Blevo66/chassis-bench/files/rocker-c/rocker-h-smooth-3d-under.gif

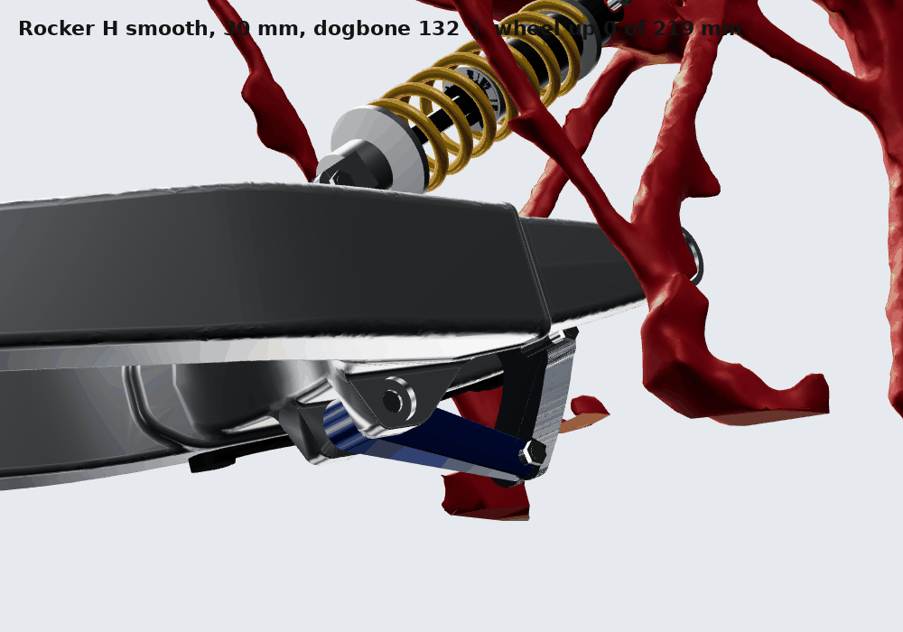
files/rocker-c/rocker-h-smooth-3d-under.gif
