Blevo66/chassis-bench/files/rocker-c/render-joel-rocker/render-side.jpg

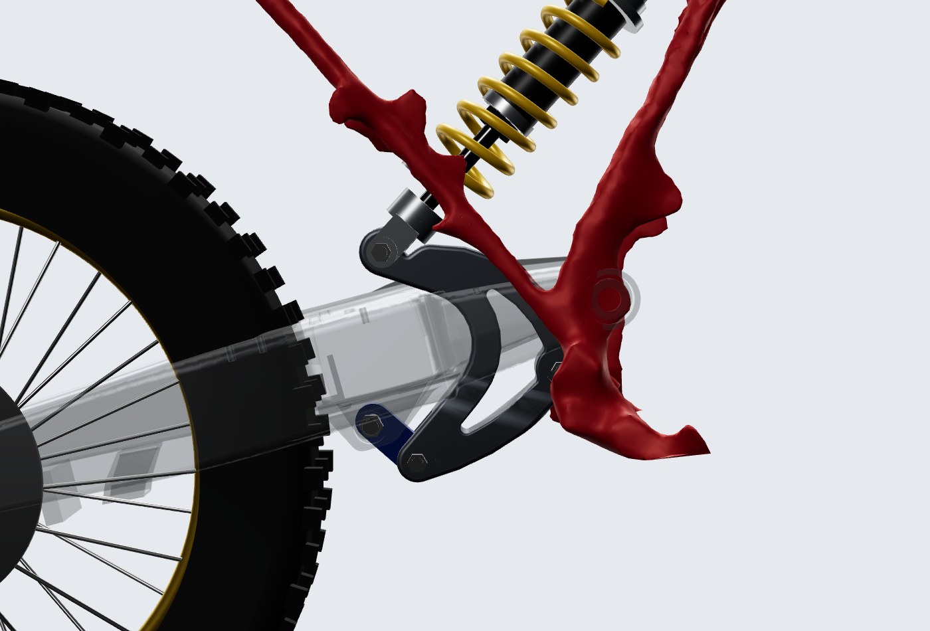
files/rocker-c/render-joel-rocker/render-side.jpg
