Blevo66/chassis-bench/files/sketches/bike-sketch-sheets-concept-50.pdf

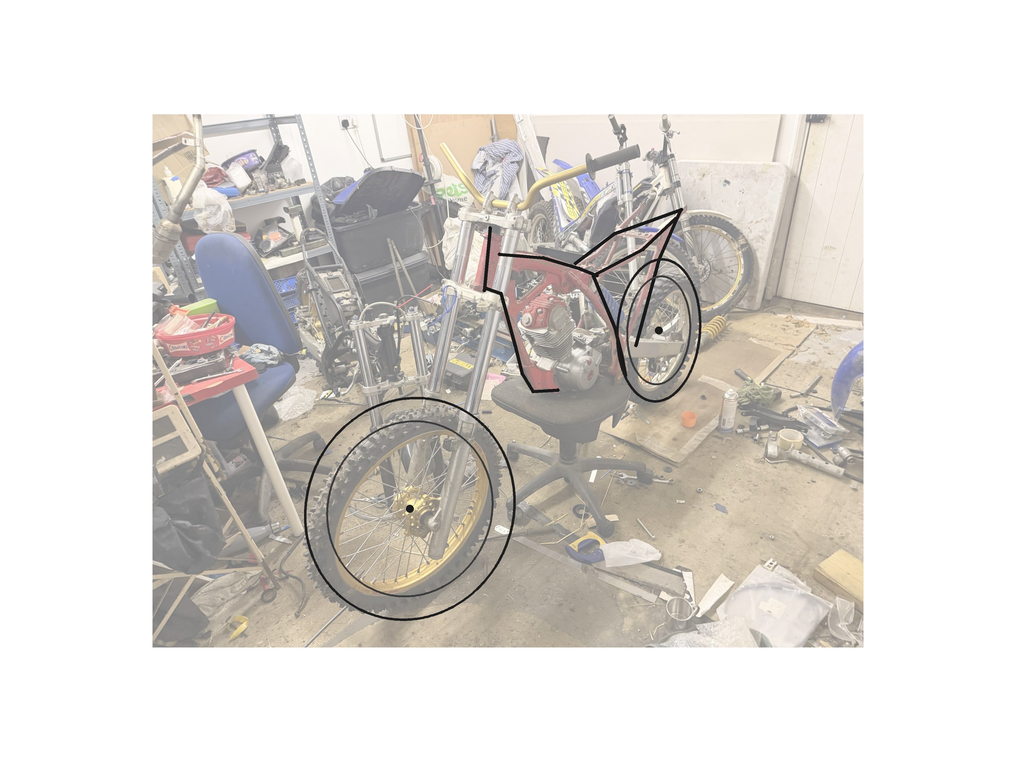
[picture p3: page 1]
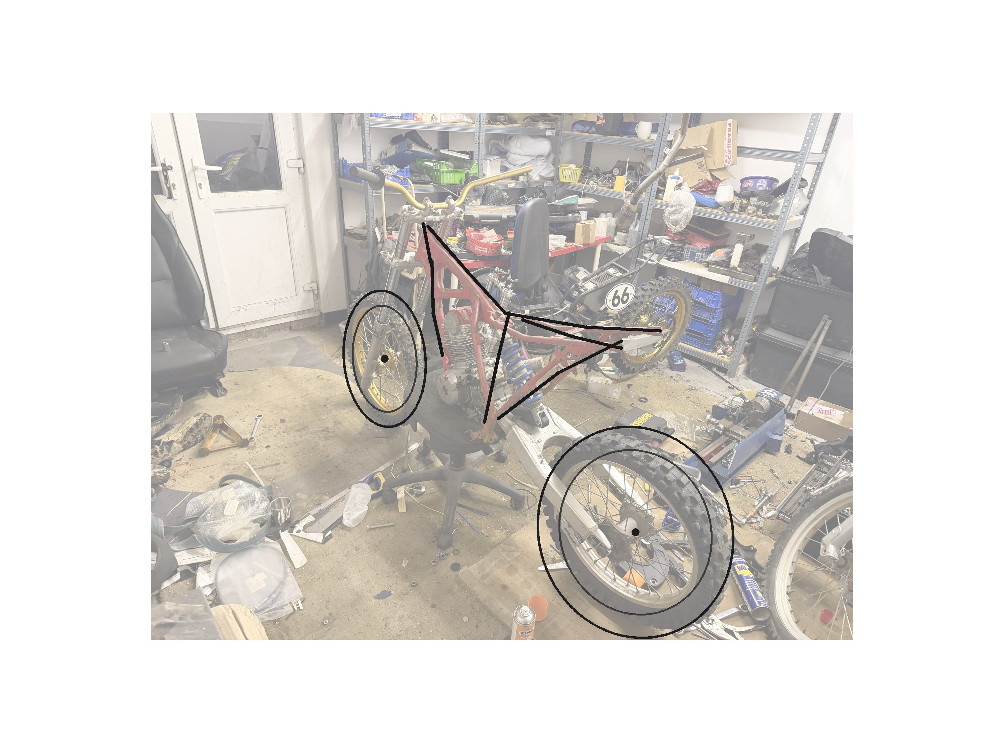
[picture p4: page 2]
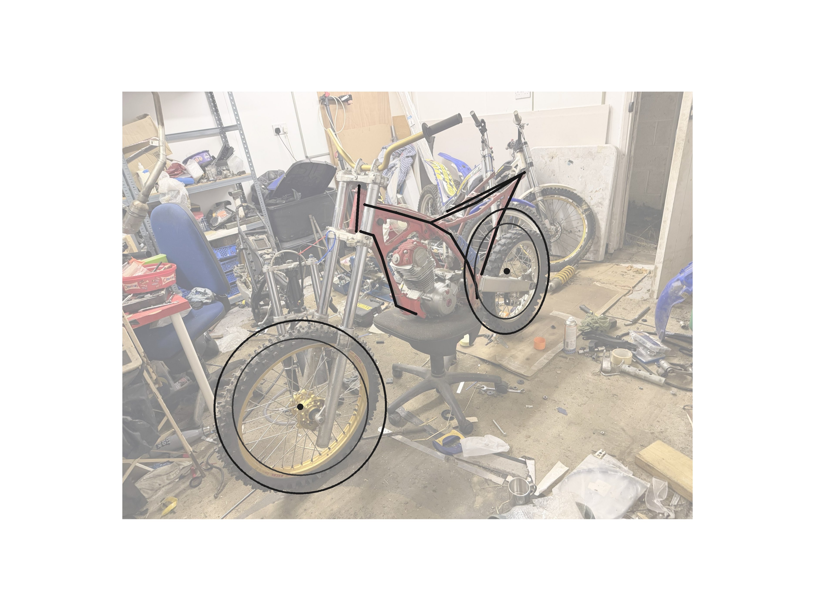
[picture p5: page 3]
