Blevo66/chassis-bench/files/sketches/bike-sketch-sheets-concept.pdf

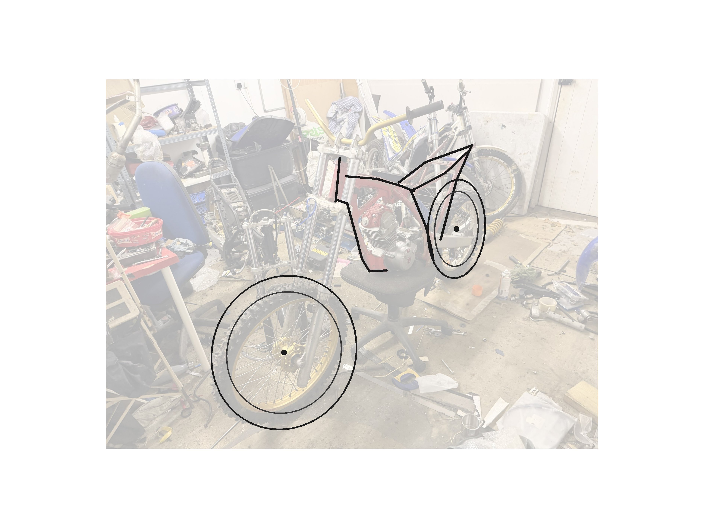
[picture p6: page 1]
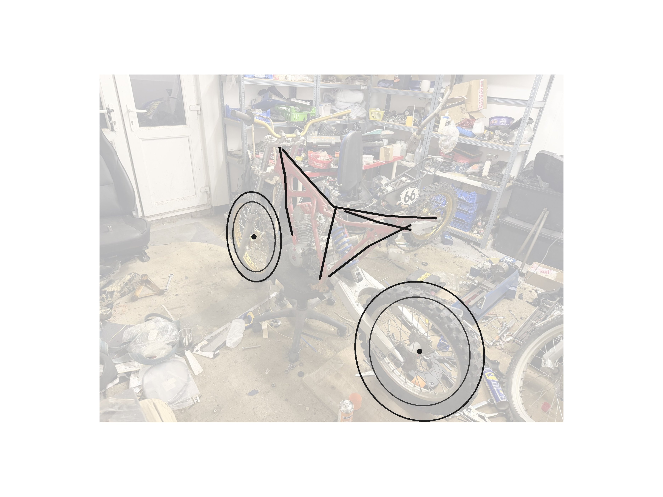
[picture p7: page 2]
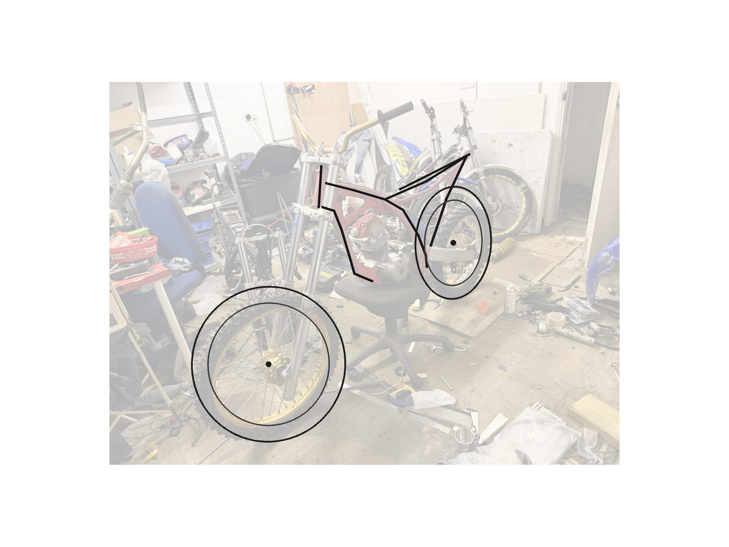
[picture p8: page 3]
