Blevo66/chassis-bench/files/sketches/bike-sketch-sheets-landscape-50.pdf

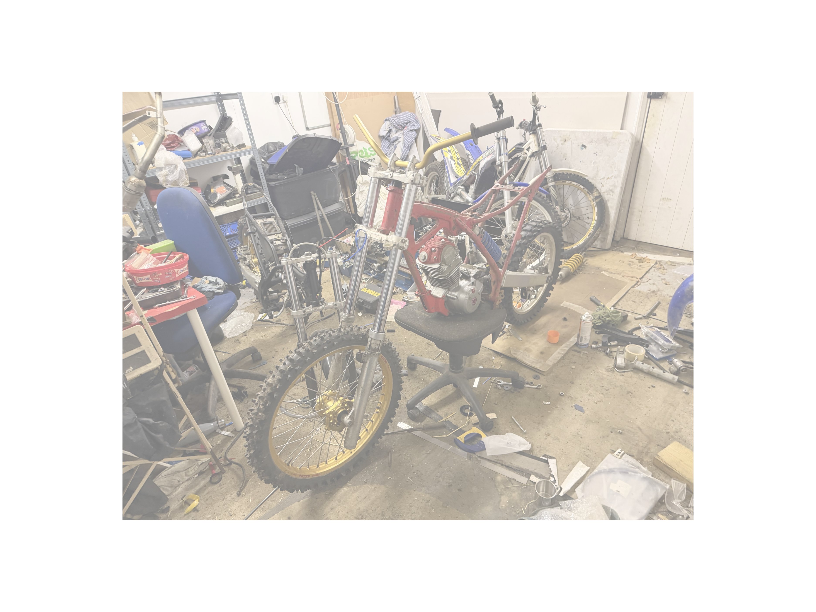
[picture p9: page 1]
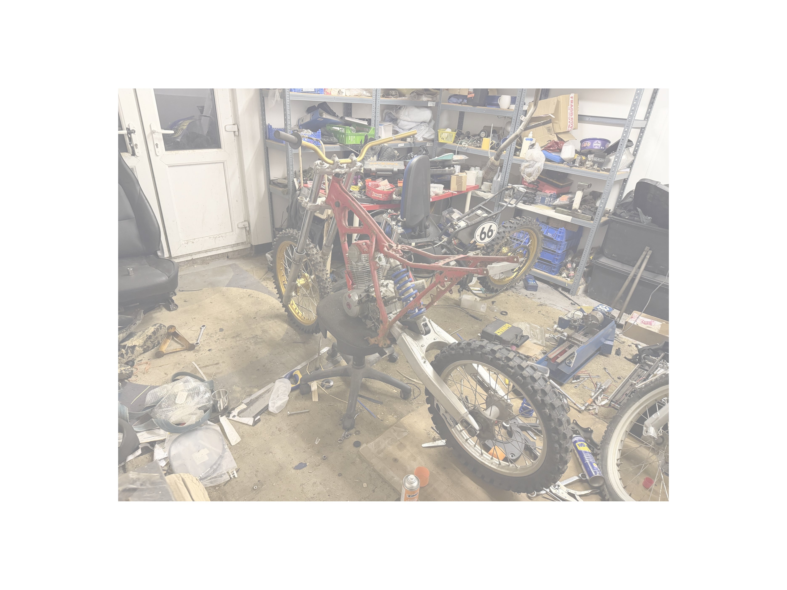
[picture p10: page 2]
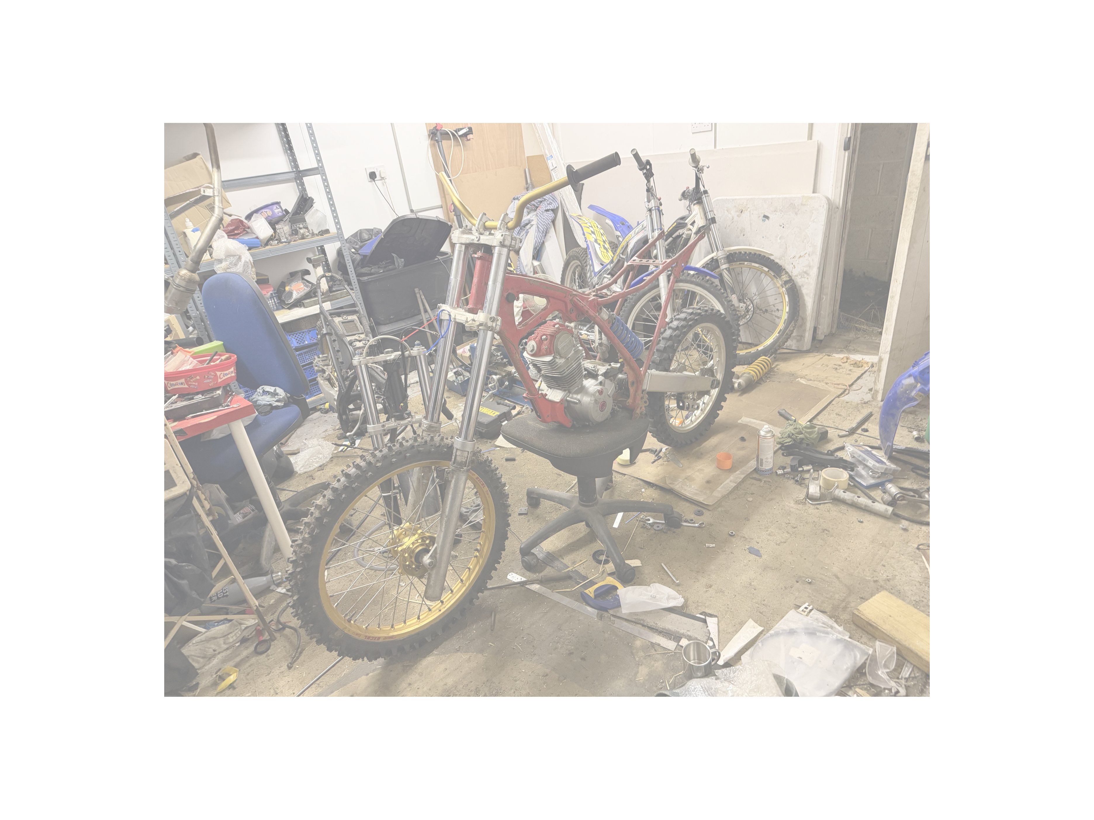
[picture p11: page 3]
