Blevo66/chassis-bench/files/sketches/bike-sketch-sheets.pdf

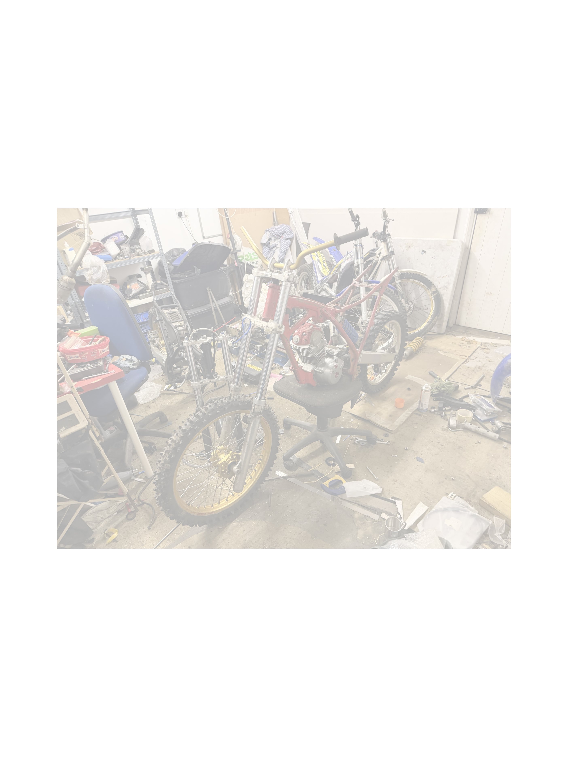
[picture p15: page 1]
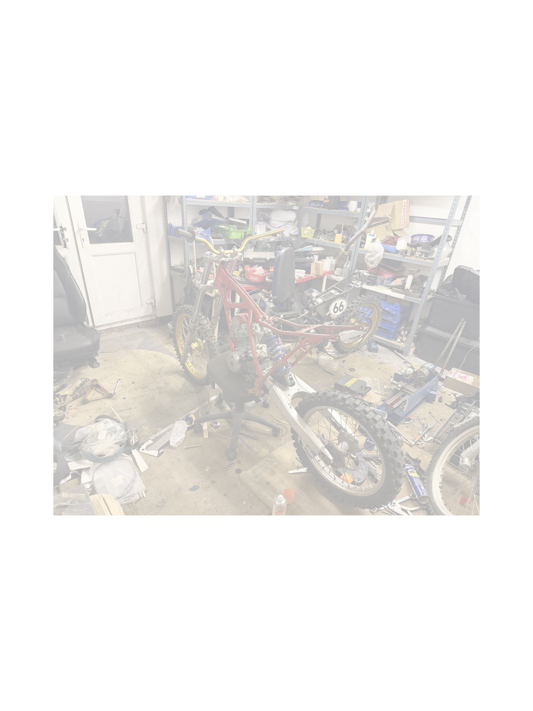
[picture p16: page 2]
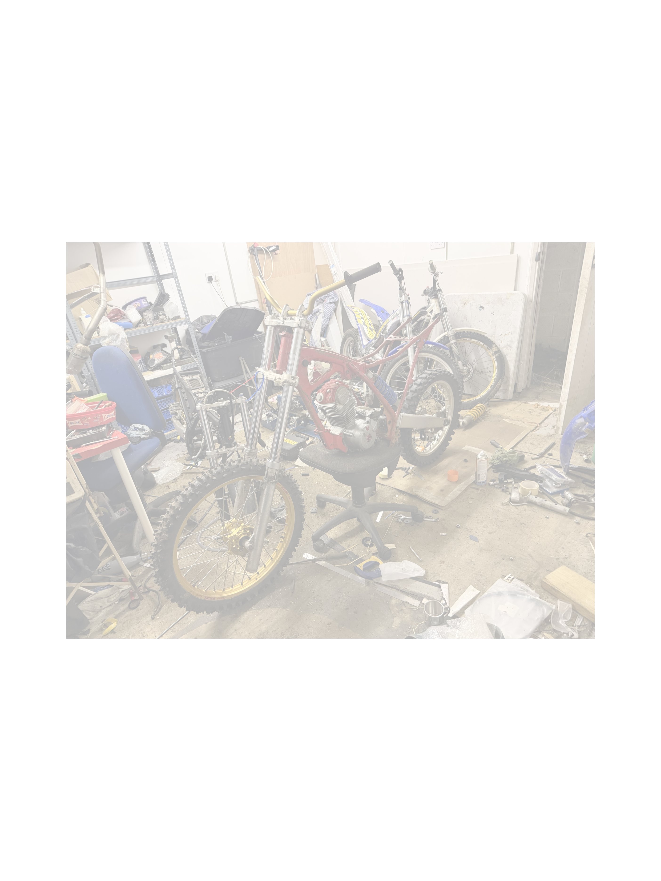
[picture p17: page 3]
