Blevo66/chassis-bench/files/linkage/compare-A-B.png

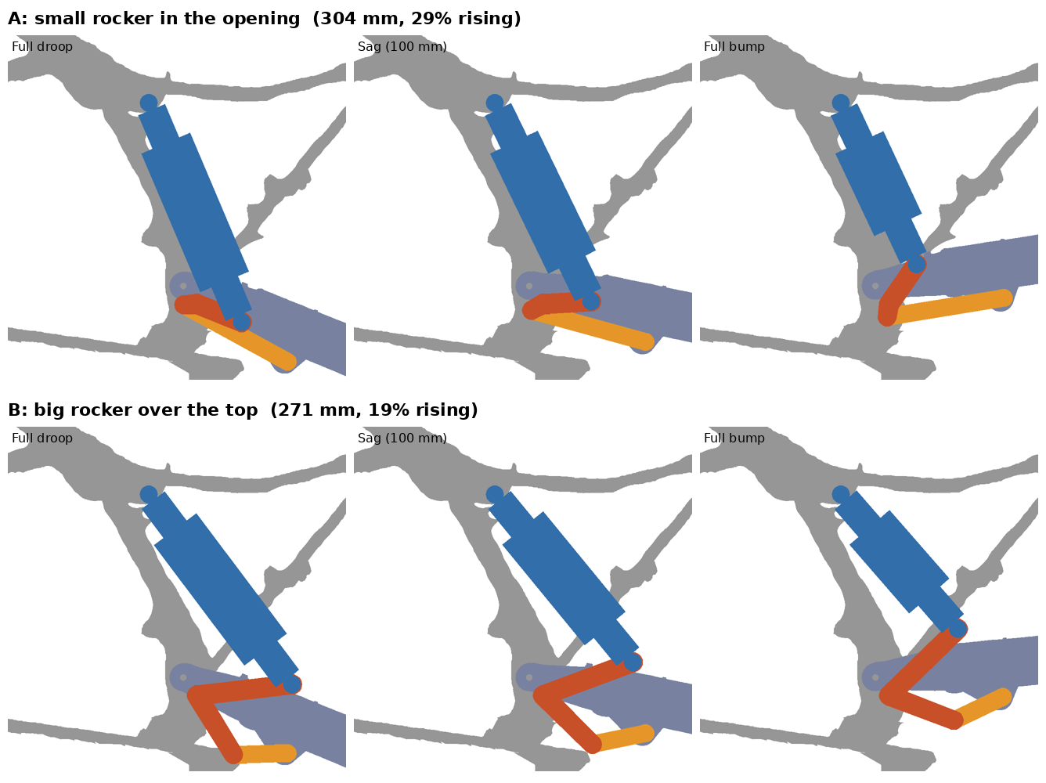
files/linkage/compare-A-B.png
