Blevo66/chassis-bench/files/rocker-c/crf-style-check.png

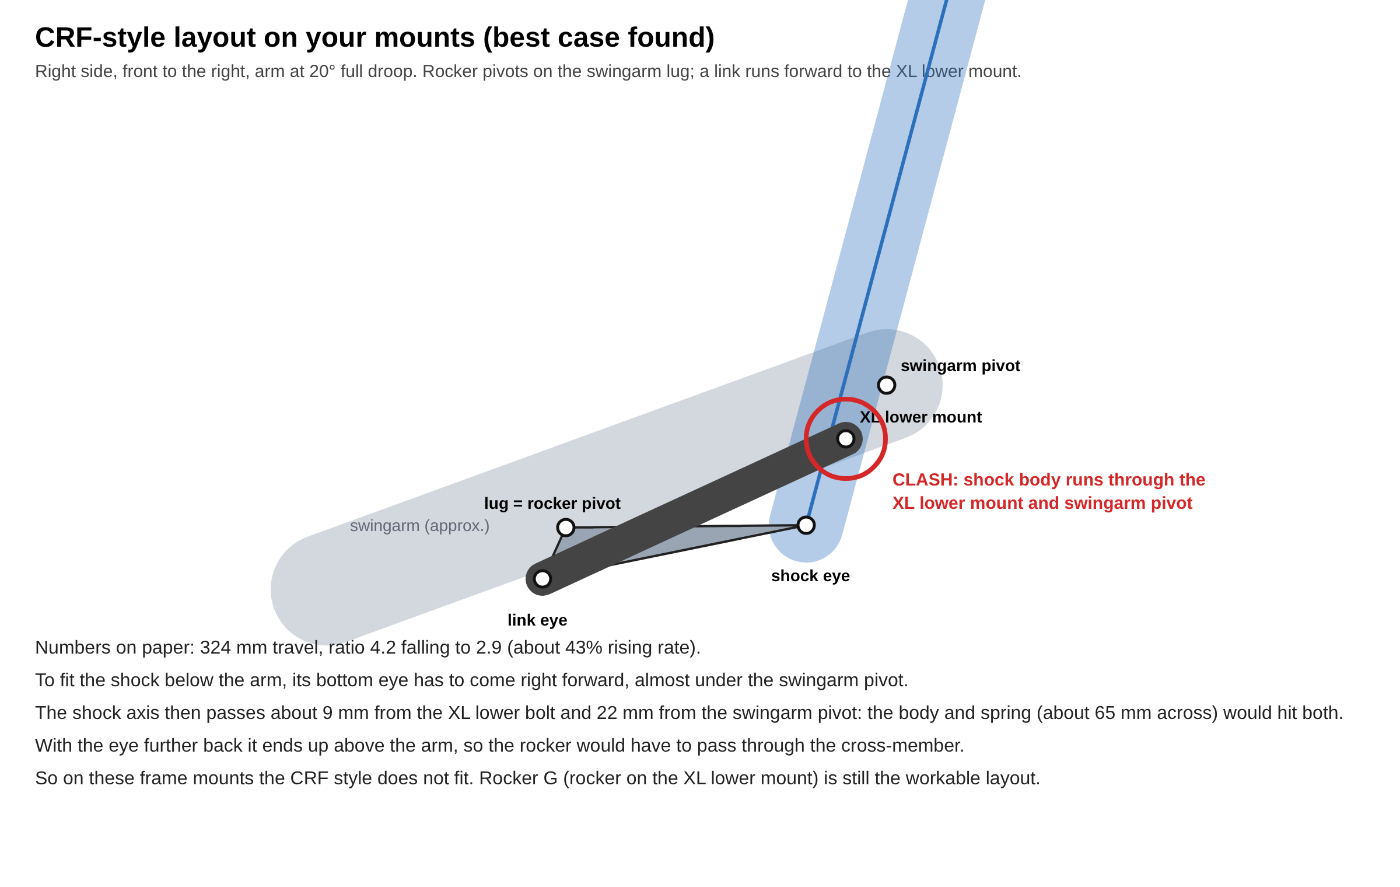
files/rocker-c/crf-style-check.png
