Blevo66/chassis-bench/files/rocker-c/gap-options.png

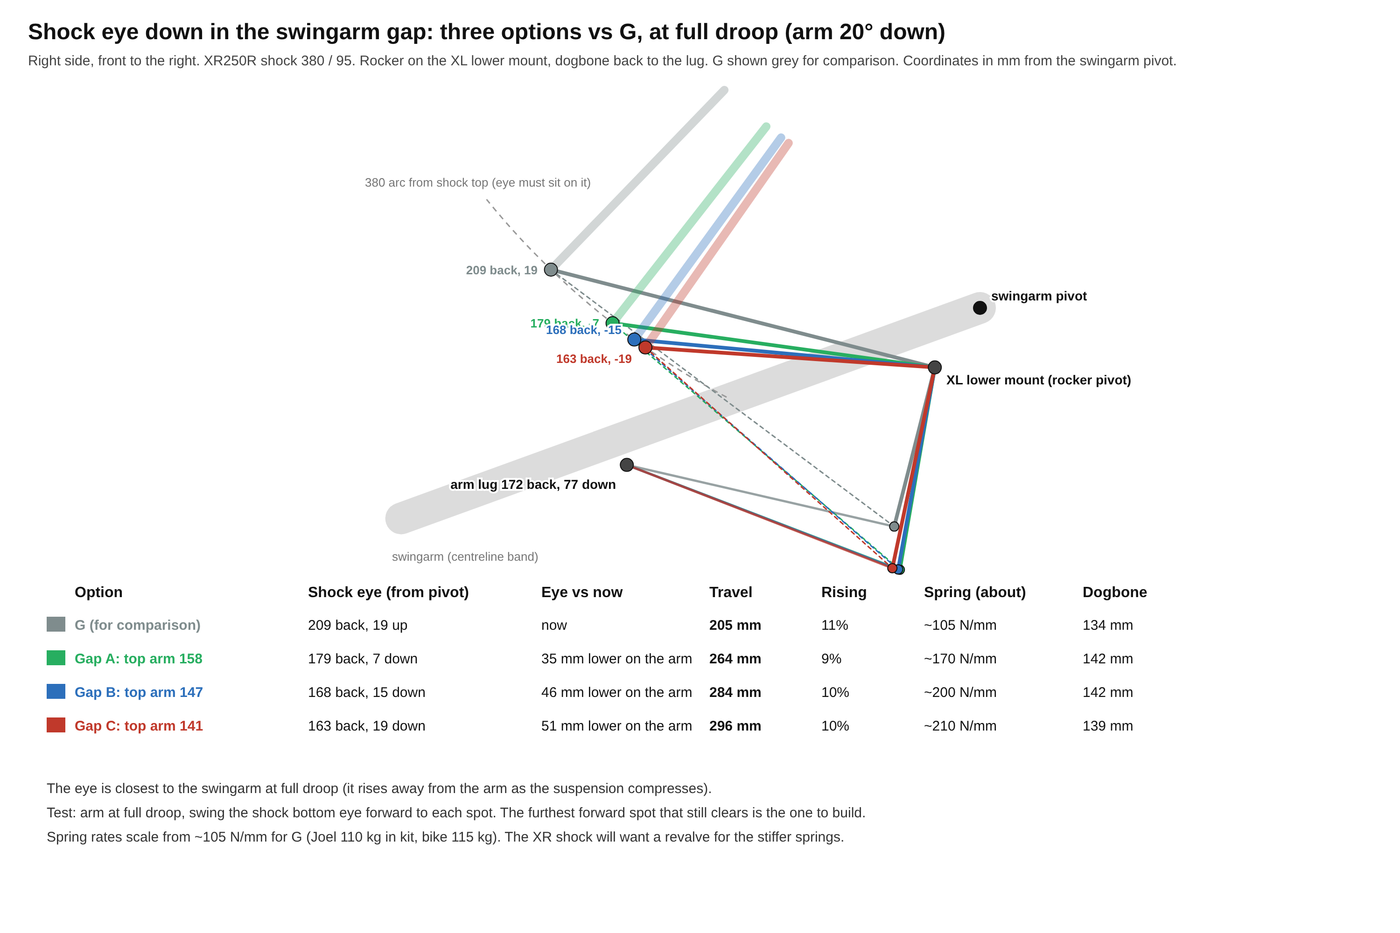
files/rocker-c/gap-options.png
