Blevo66/chassis-bench/files/rocker-c/render-joel-rocker/render-bottom.jpg

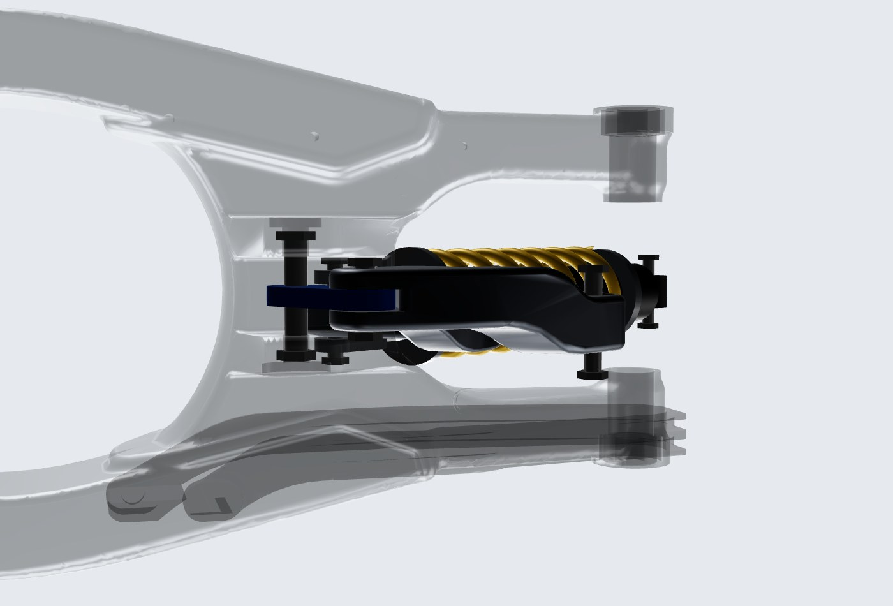
files/rocker-c/render-joel-rocker/render-bottom.jpg
