Blevo66/chassis-bench/files/rocker-c/render-joel-rocker/render-front34.jpg

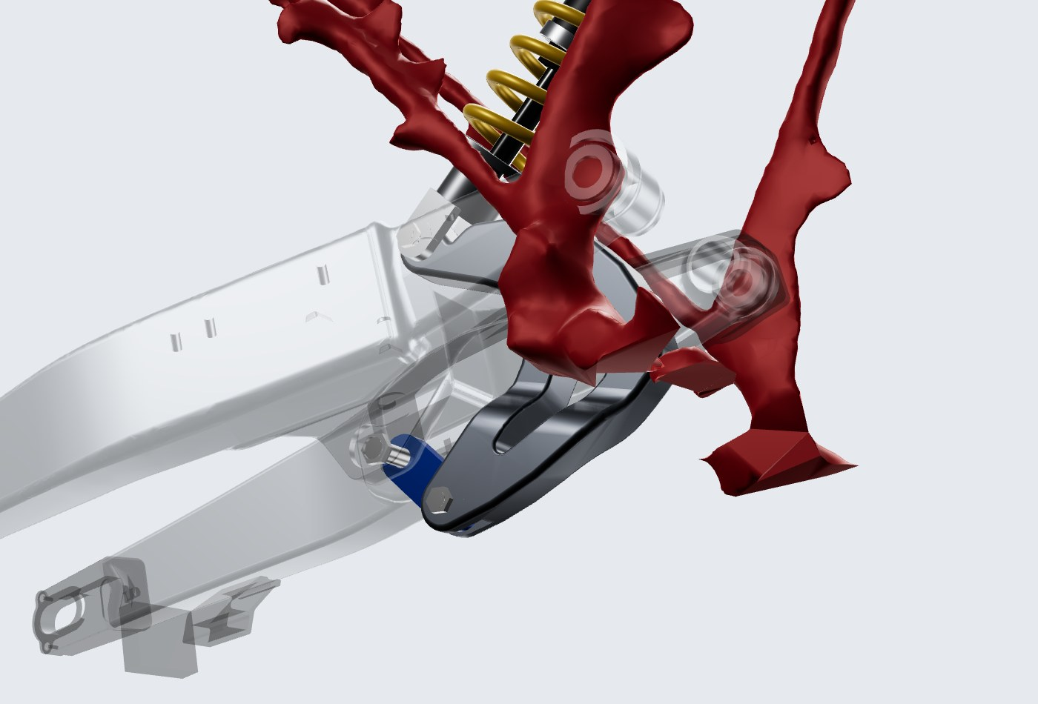
files/rocker-c/render-joel-rocker/render-front34.jpg
