Blevo66/chassis-bench/files/rocker-c/render-joel-rocker/render-hero.jpg

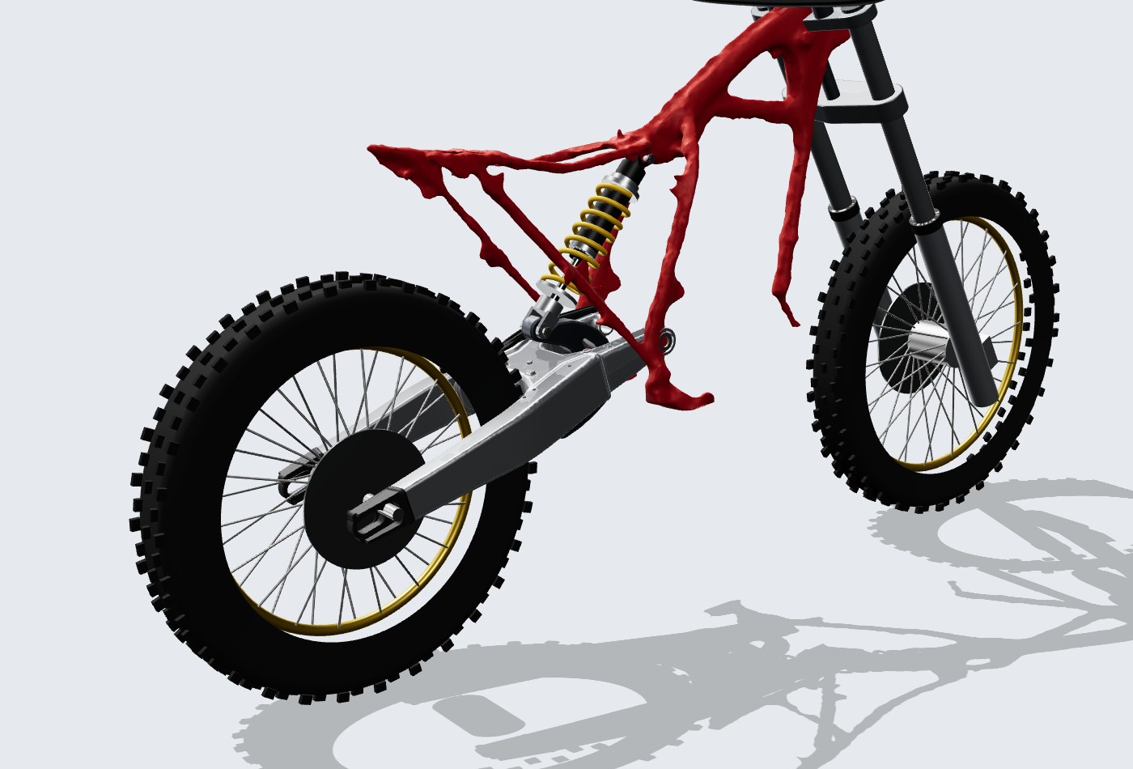
files/rocker-c/render-joel-rocker/render-hero.jpg
