Blevo66/chassis-bench/files/rocker-c/render-joel-rocker/render-side_bump.jpg

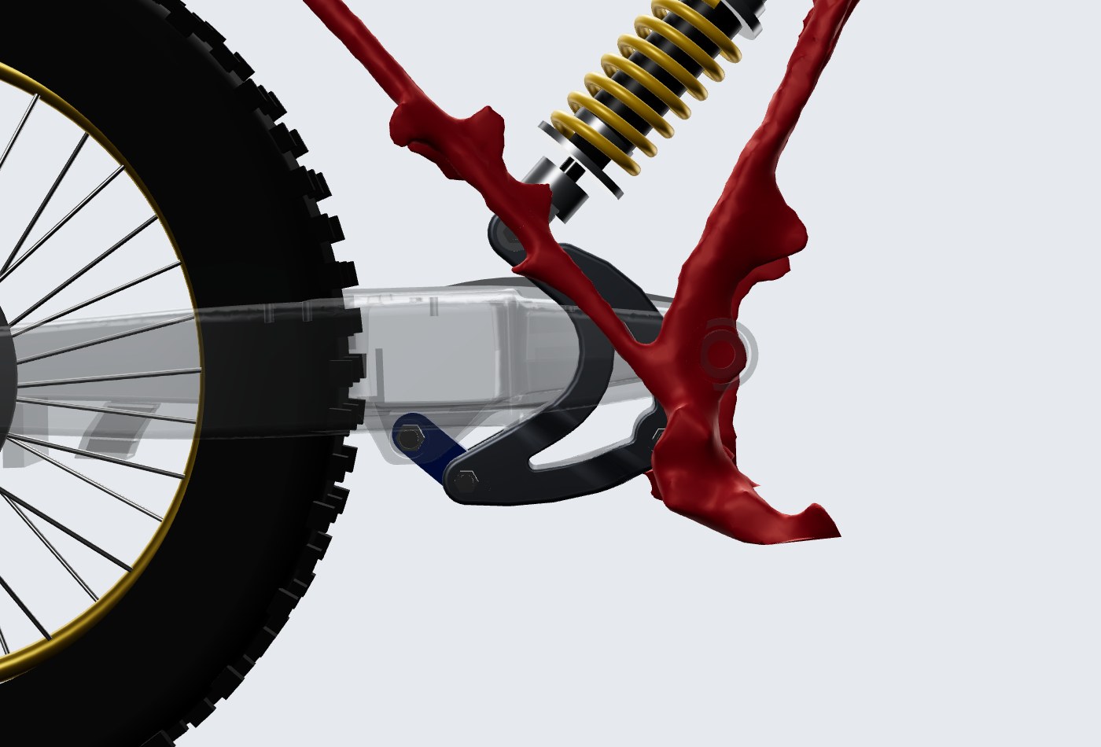
files/rocker-c/render-joel-rocker/render-side_bump.jpg
