Blevo66/chassis-bench/files/rocker-c/render-joel-rocker/render-side_droop.jpg

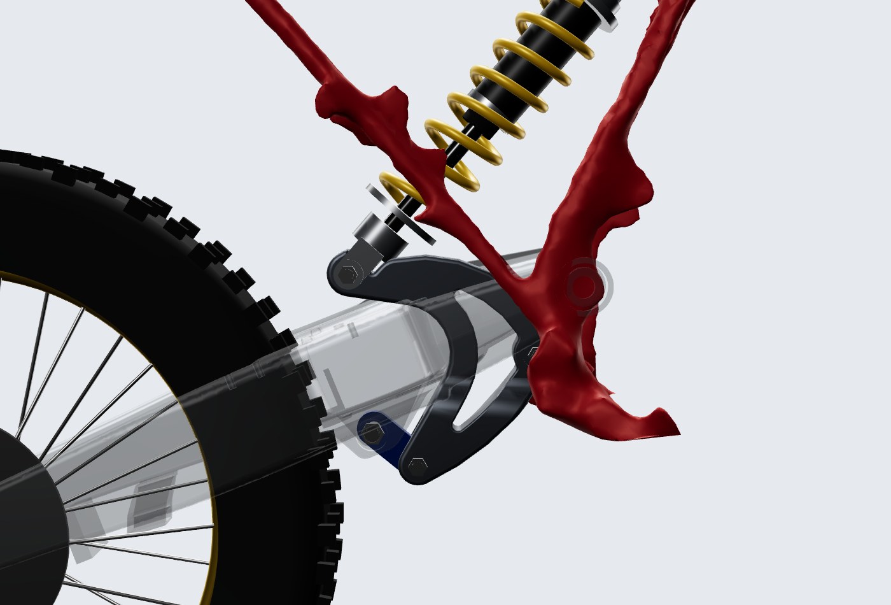
files/rocker-c/render-joel-rocker/render-side_droop.jpg
