Blevo66/chassis-bench/files/rocker-c/render-joel-rocker/render-under.jpg

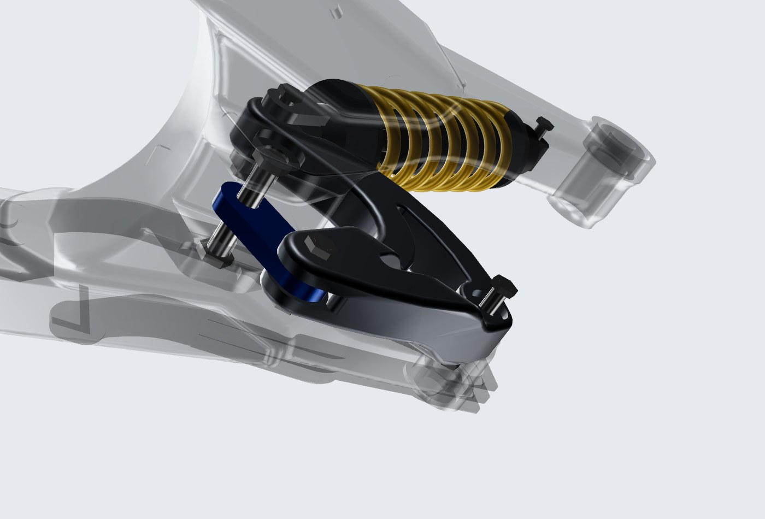
files/rocker-c/render-joel-rocker/render-under.jpg
