Blevo66/chassis-bench/files/rocker-c/render-joel-rocker/rocker-travel-front34.gif

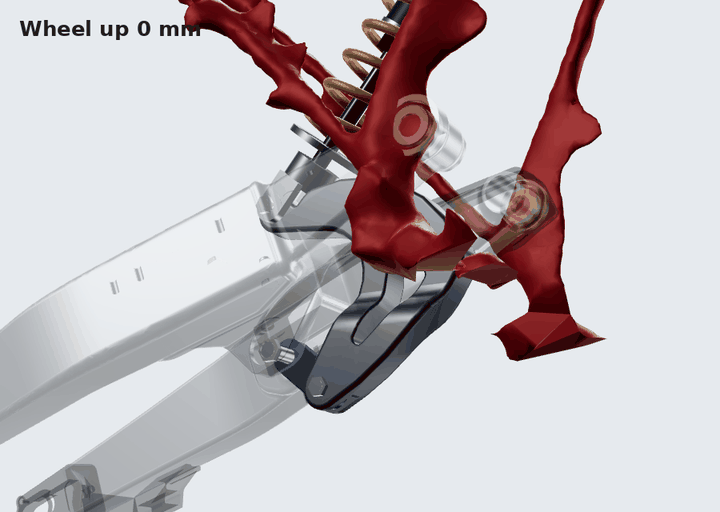
files/rocker-c/render-joel-rocker/rocker-travel-front34.gif
