Blevo66/chassis-bench/files/rocker-c/render-rocker-v3/alone_a.jpg

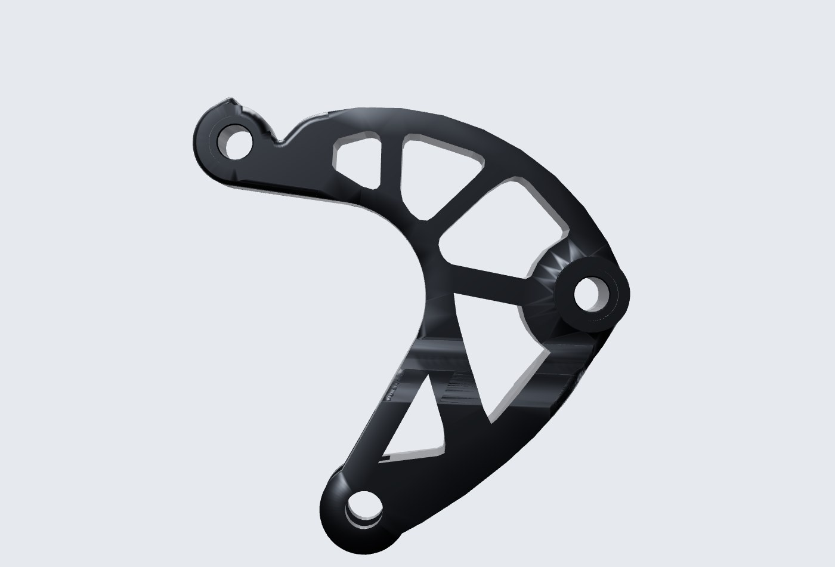
files/rocker-c/render-rocker-v3/alone_a.jpg
