Blevo66/chassis-bench/files/rocker-c/render-rocker-v3/alone_b.jpg

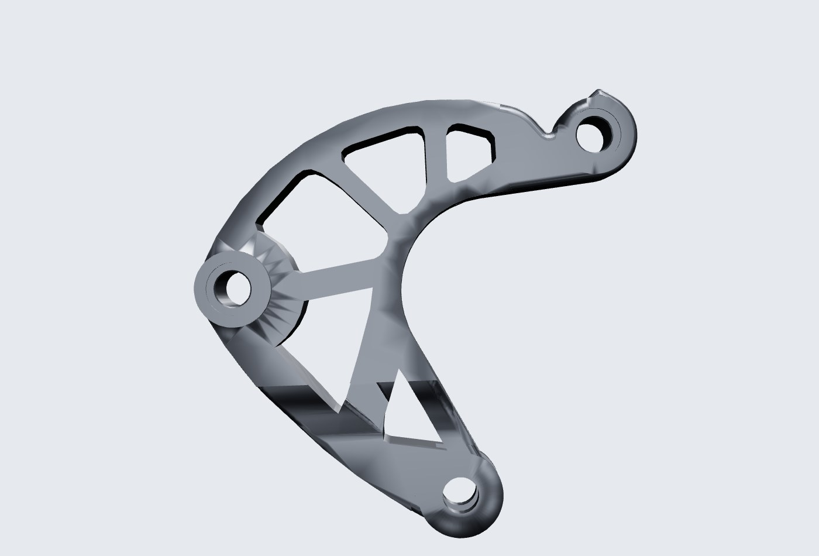
files/rocker-c/render-rocker-v3/alone_b.jpg
