Blevo66/chassis-bench/files/rocker-c/render-rocker-v3/pivot_close.jpg

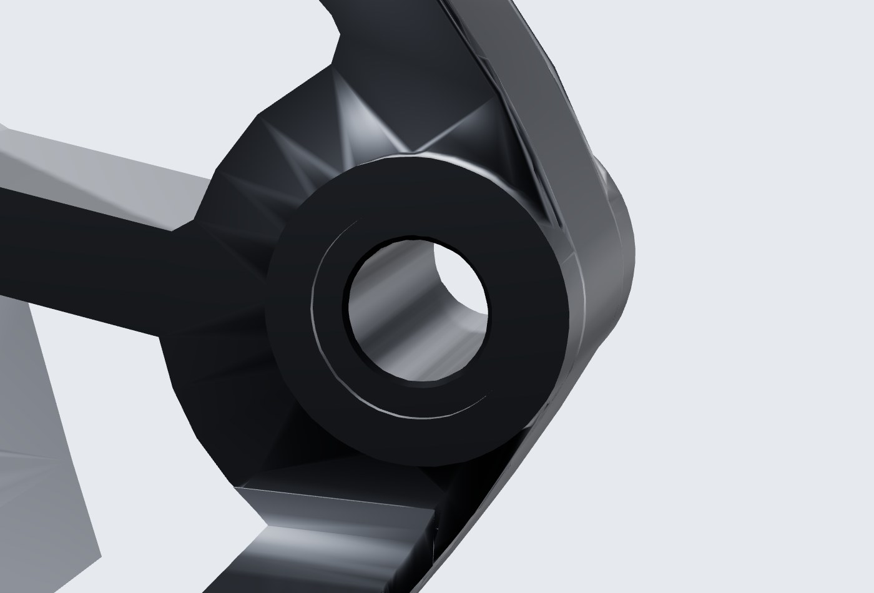
files/rocker-c/render-rocker-v3/pivot_close.jpg
