Blevo66/chassis-bench/files/rocker-c/render-rocker-v3/pivot_close_b.jpg

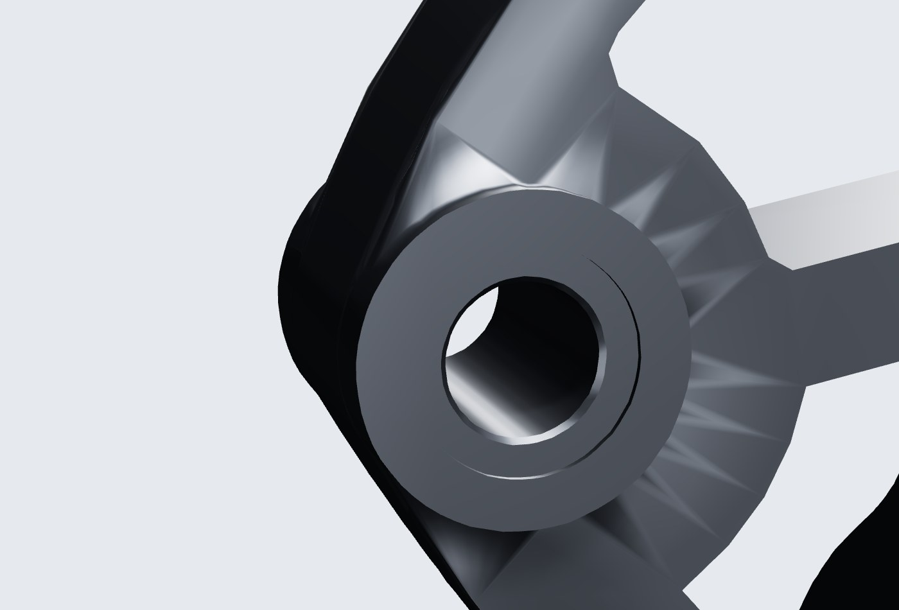
files/rocker-c/render-rocker-v3/pivot_close_b.jpg
