Blevo66/chassis-bench/files/rocker-c/render-rocker-v3/shock_close.jpg

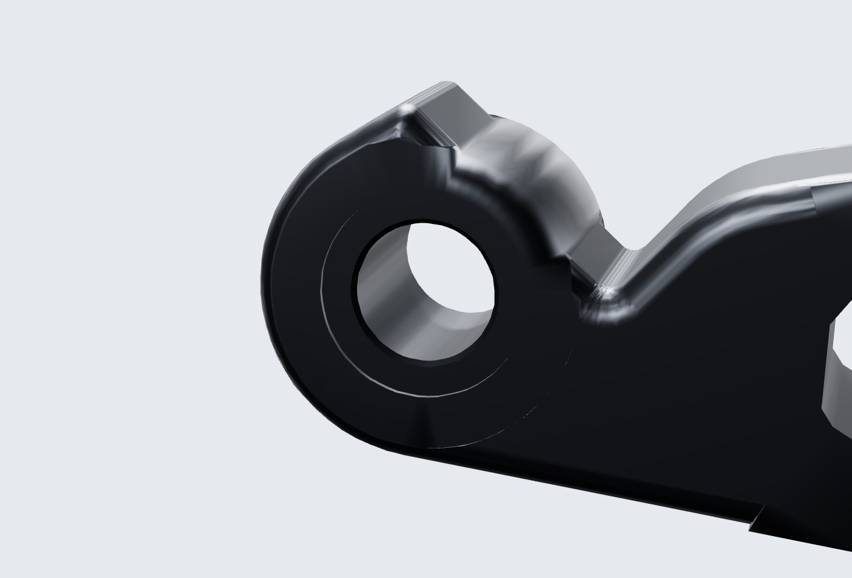
files/rocker-c/render-rocker-v3/shock_close.jpg
