Blevo66/chassis-bench/files/rocker-c/rocker-c-205-drawing.png

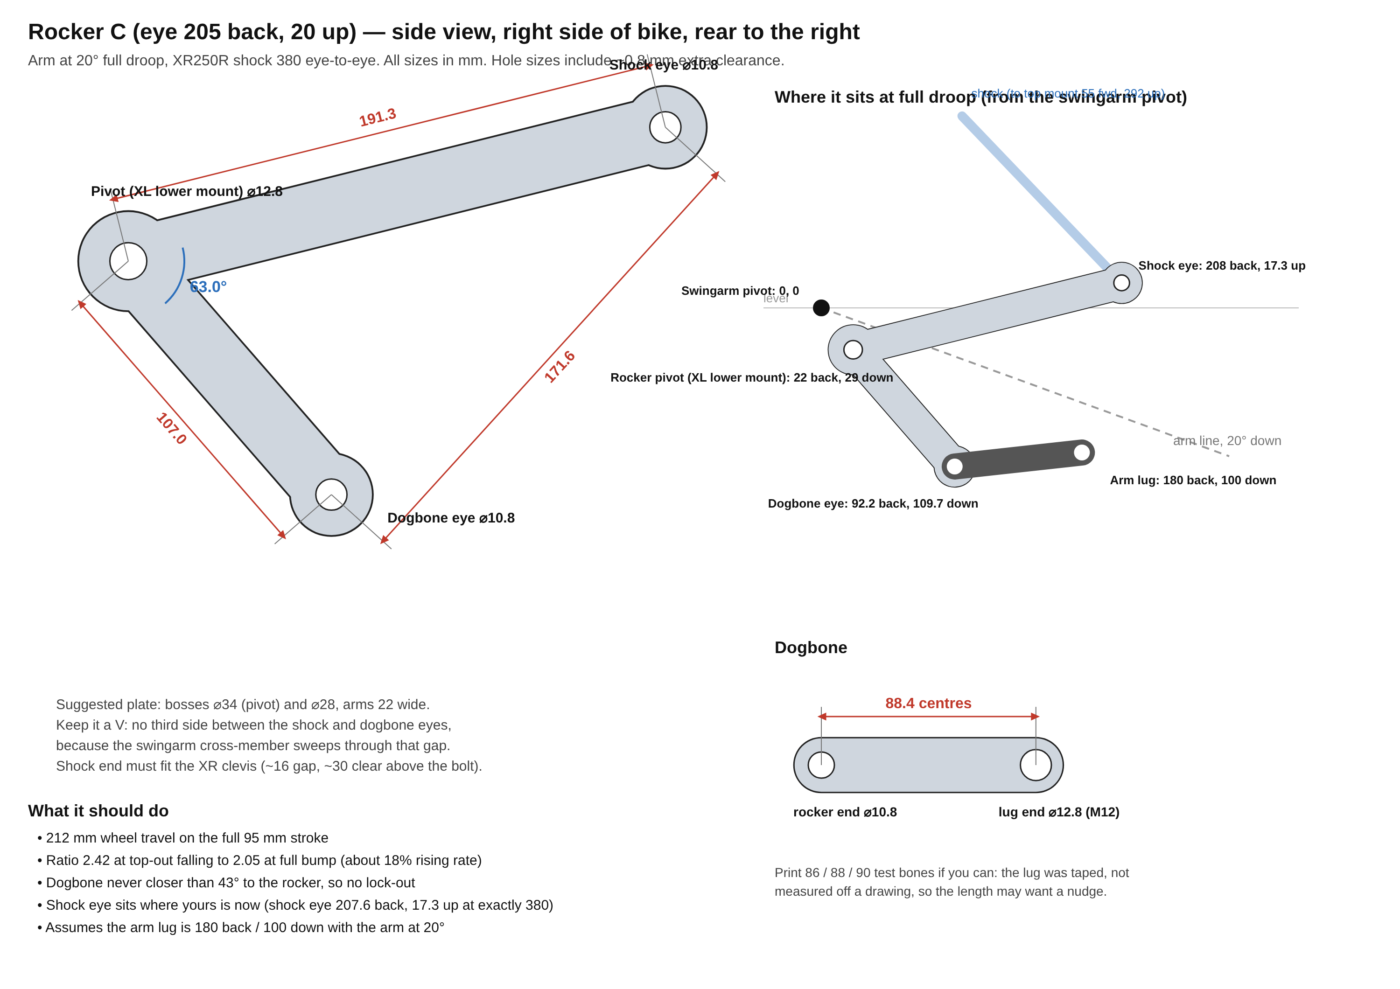
files/rocker-c/rocker-c-205-drawing.png
