Blevo66/chassis-bench/files/rocker-c/rocker-d2-drawing.png

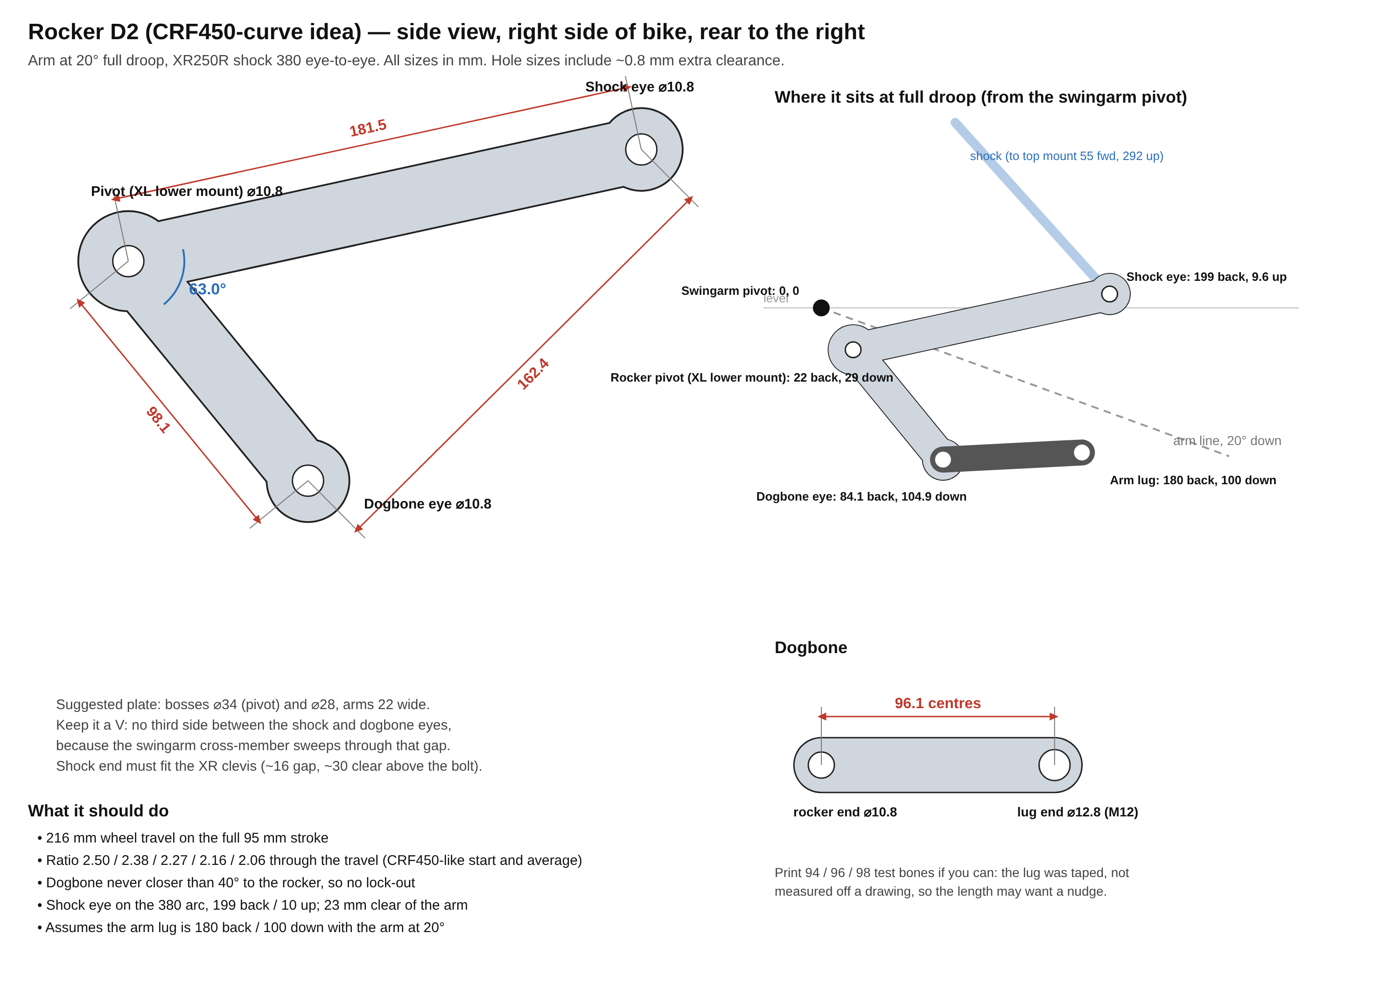
files/rocker-c/rocker-d2-drawing.png
