Blevo66/chassis-bench/files/rocker-c/rocker-h-3d-pivot-zoom.png

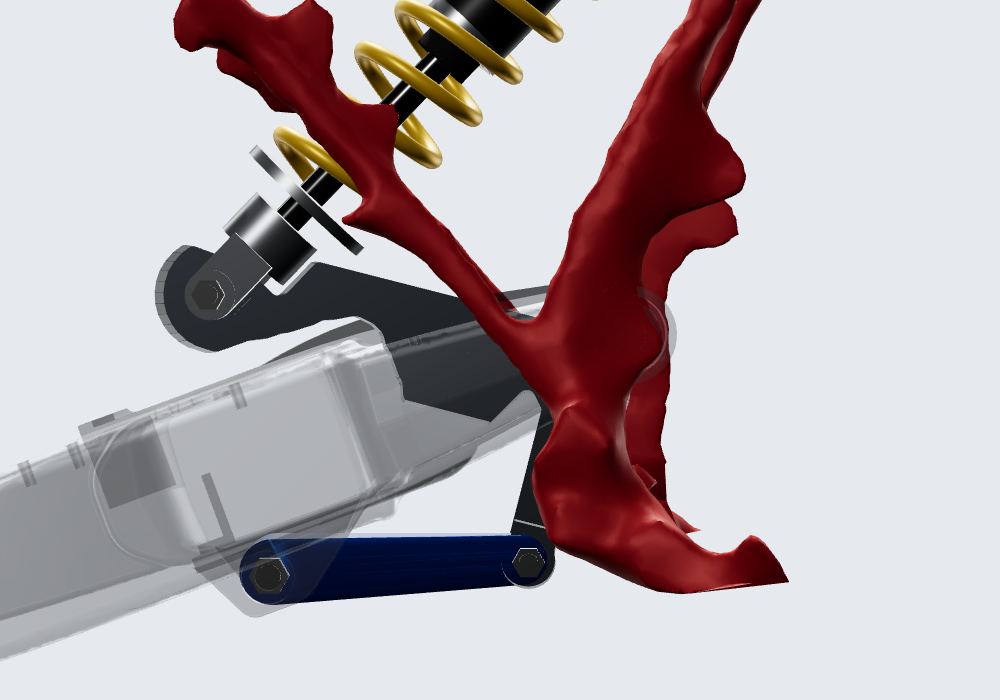
files/rocker-c/rocker-h-3d-pivot-zoom.png
