Blevo66/chassis-bench/files/rocker-c/rocker-h-3d-side-droop.png

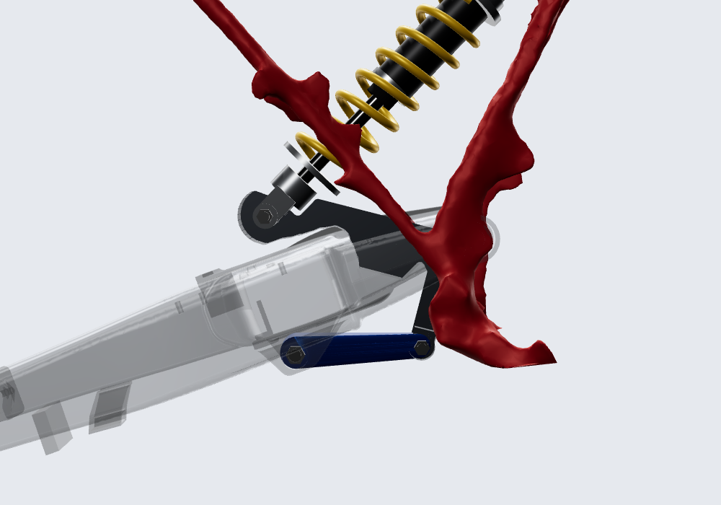
files/rocker-c/rocker-h-3d-side-droop.png
