Blevo66/chassis-bench/files/rocker-c/rocker-h-alloy-3d.png

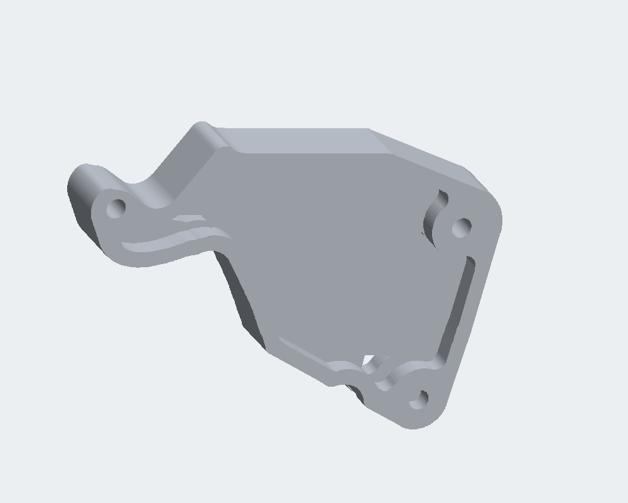
files/rocker-c/rocker-h-alloy-3d.png
