Blevo66/chassis-bench/files/rocker-c/rocker-h-alloy-stress.png

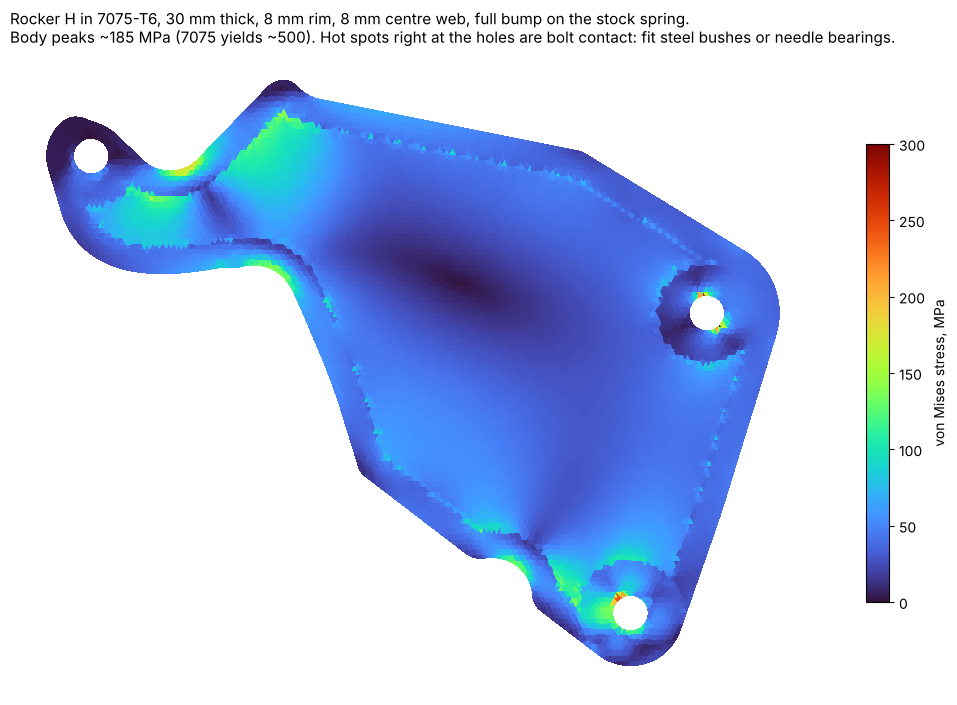
files/rocker-c/rocker-h-alloy-stress.png
