Blevo66/chassis-bench/files/rocker-c/rocker-h-smooth-drawing.png

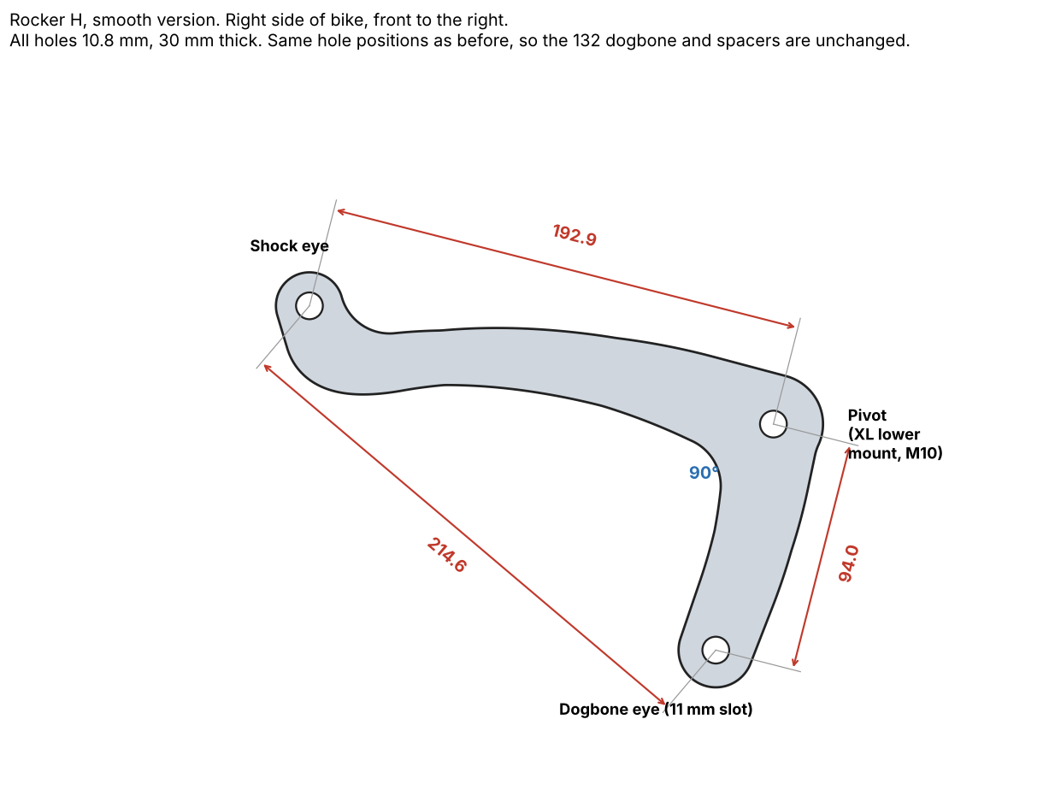
files/rocker-c/rocker-h-smooth-drawing.png
