Blevo66/chassis-bench/files/rocker-c/rocker-h-smooth-stress-4mm-plates.png

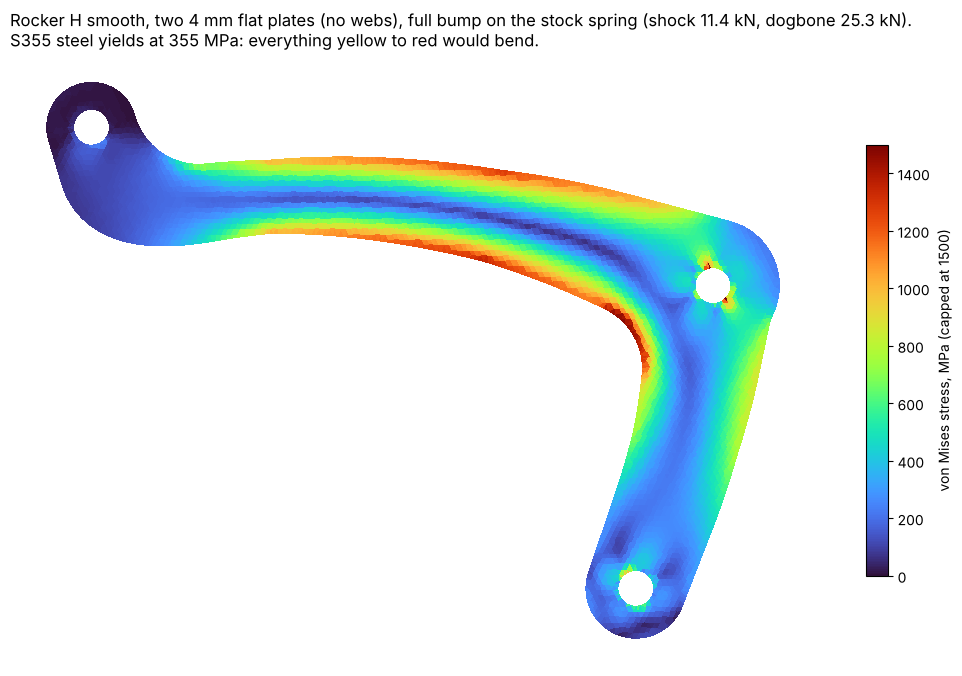
files/rocker-c/rocker-h-smooth-stress-4mm-plates.png
