Blevo66/chassis-bench/files/rocker-c/rocker-h-strong-drawing.png

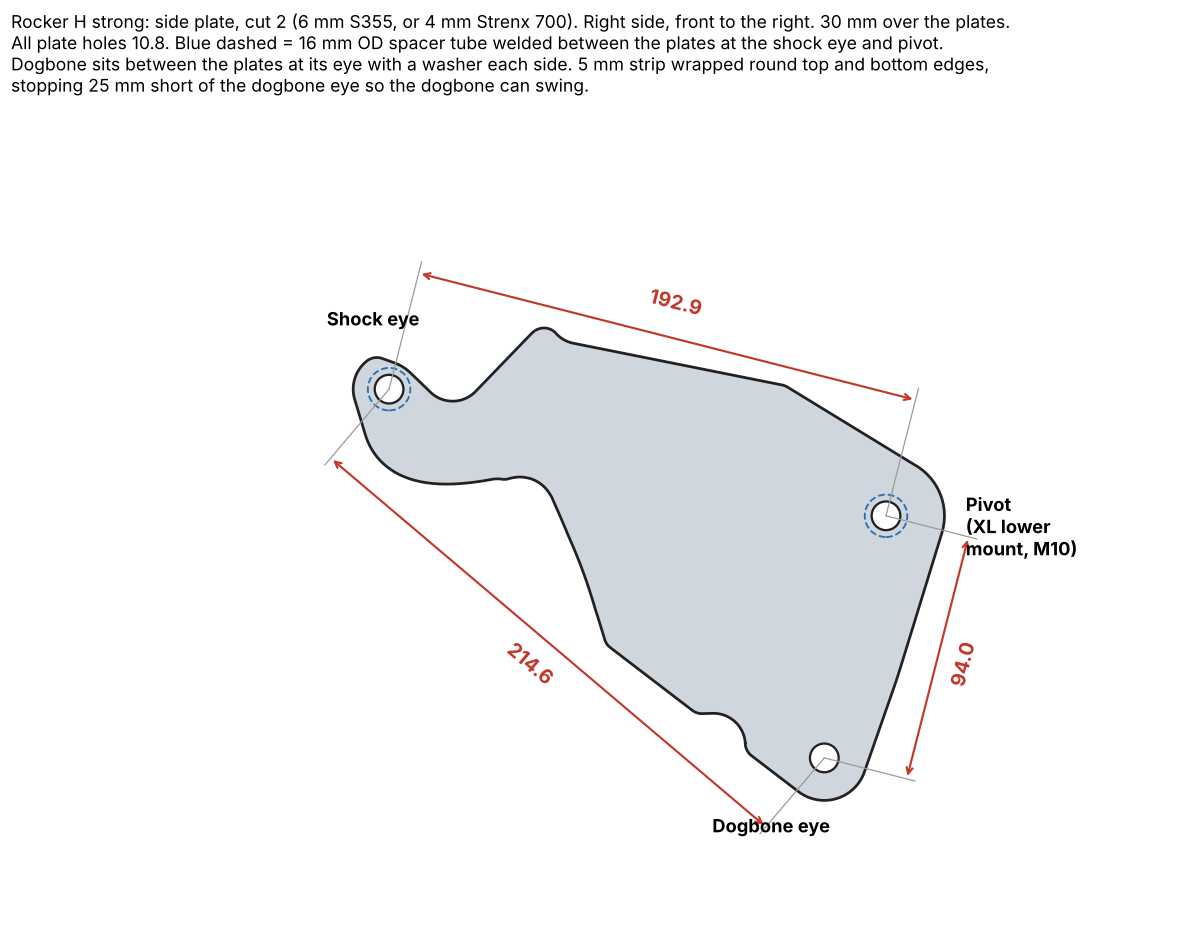
files/rocker-c/rocker-h-strong-drawing.png
