Blevo66/chassis-bench/files/rocker-c/rocker-h-vs-m-side-by-side.png

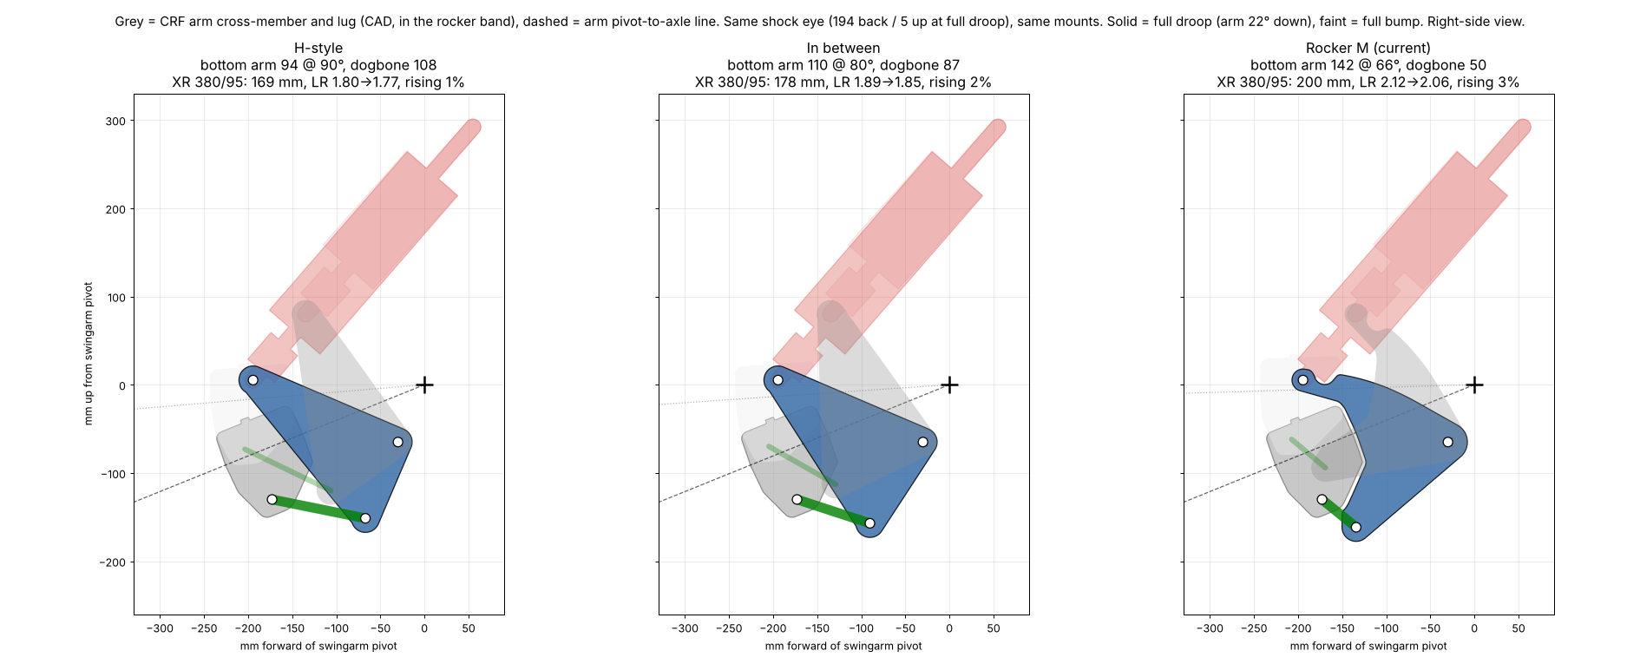
files/rocker-c/rocker-h-vs-m-side-by-side.png
