Blevo66/chassis-bench/files/rocker-c/rocker-joel-optimised-3d-stress.png

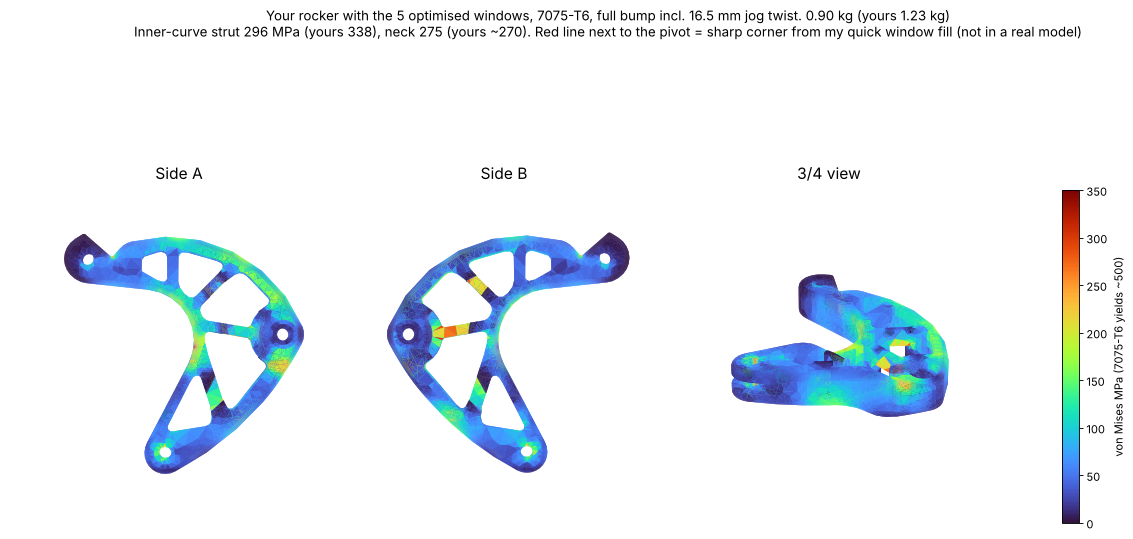
files/rocker-c/rocker-joel-optimised-3d-stress.png
