Blevo66/chassis-bench/files/rocker-c/rocker-joel-optimised-compare.png

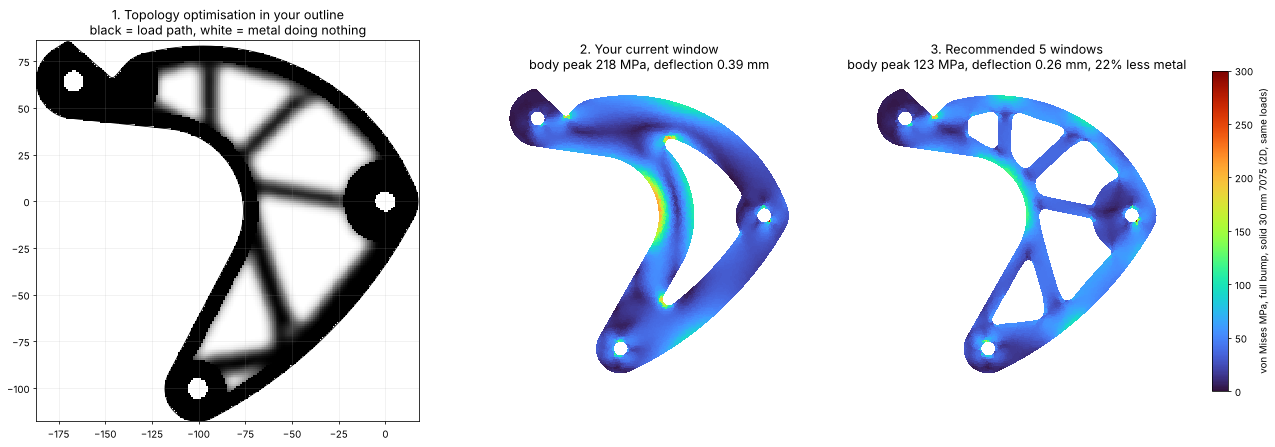
files/rocker-c/rocker-joel-optimised-compare.png
