Blevo66/chassis-bench/files/rocker-c/rocker-joel-optimised-windows.png

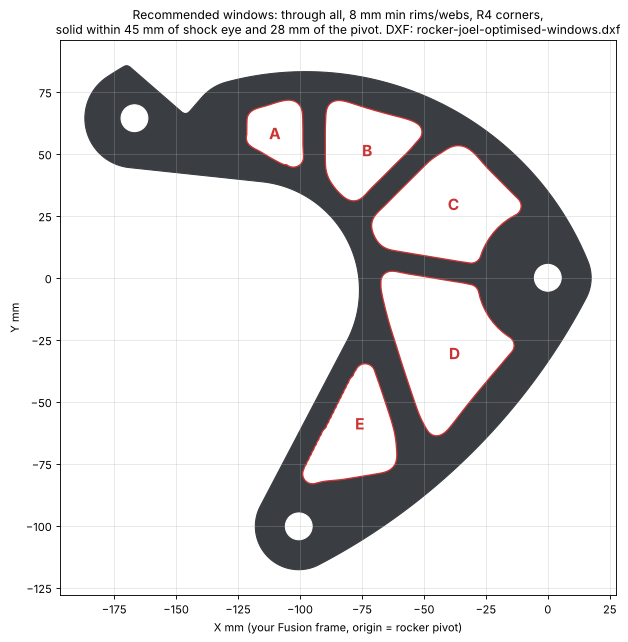
files/rocker-c/rocker-joel-optimised-windows.png
