Blevo66/chassis-bench/files/rocker-c/rocker-joel-v2-3d-stress.png

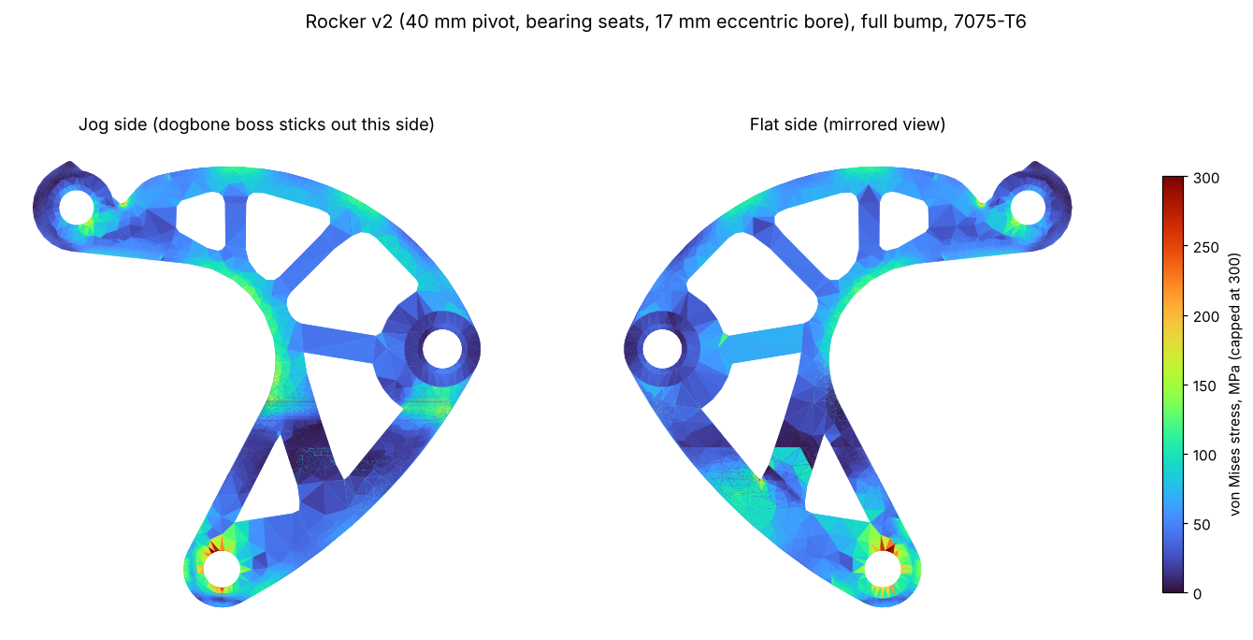
files/rocker-c/rocker-joel-v2-3d-stress.png
