Blevo66/chassis-bench/files/rocker-c/rocker-joel-v3-bush-pockets.png

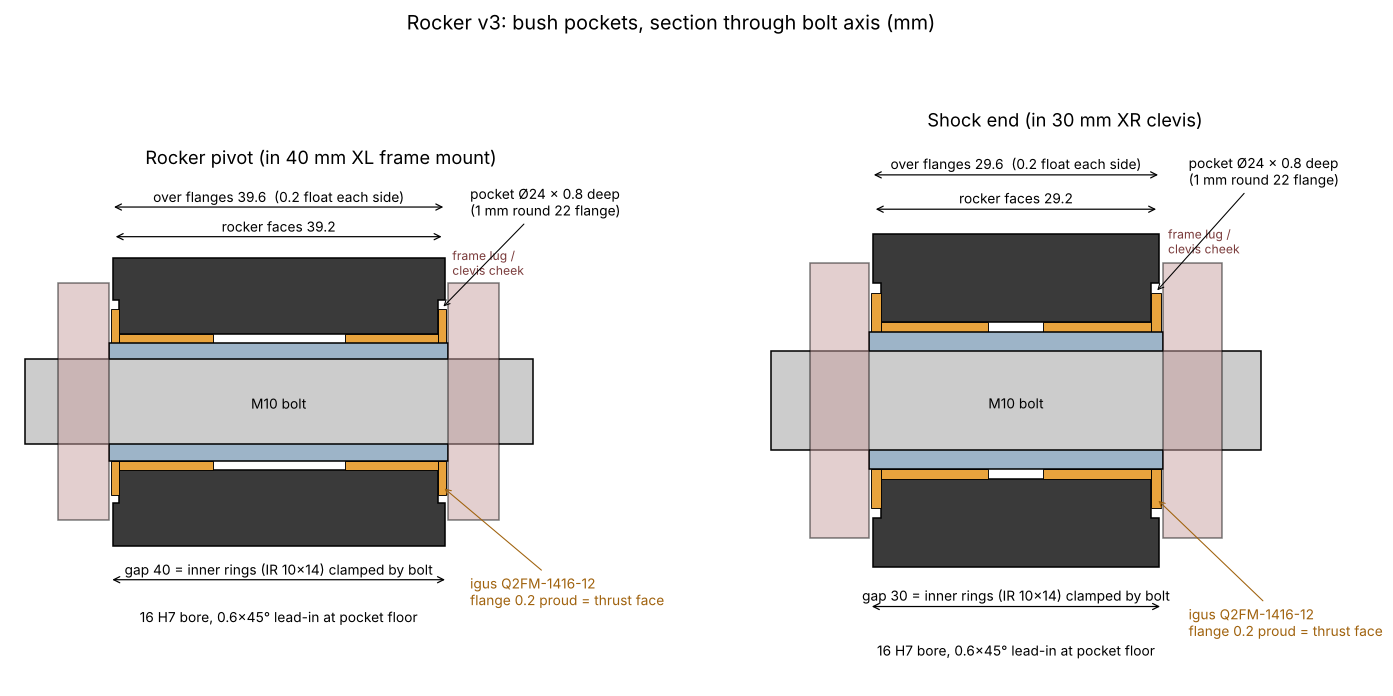
files/rocker-c/rocker-joel-v3-bush-pockets.png
