Blevo66/chassis-bench/files/rocker-c/rocker-joel-v3-bush-stacks.png

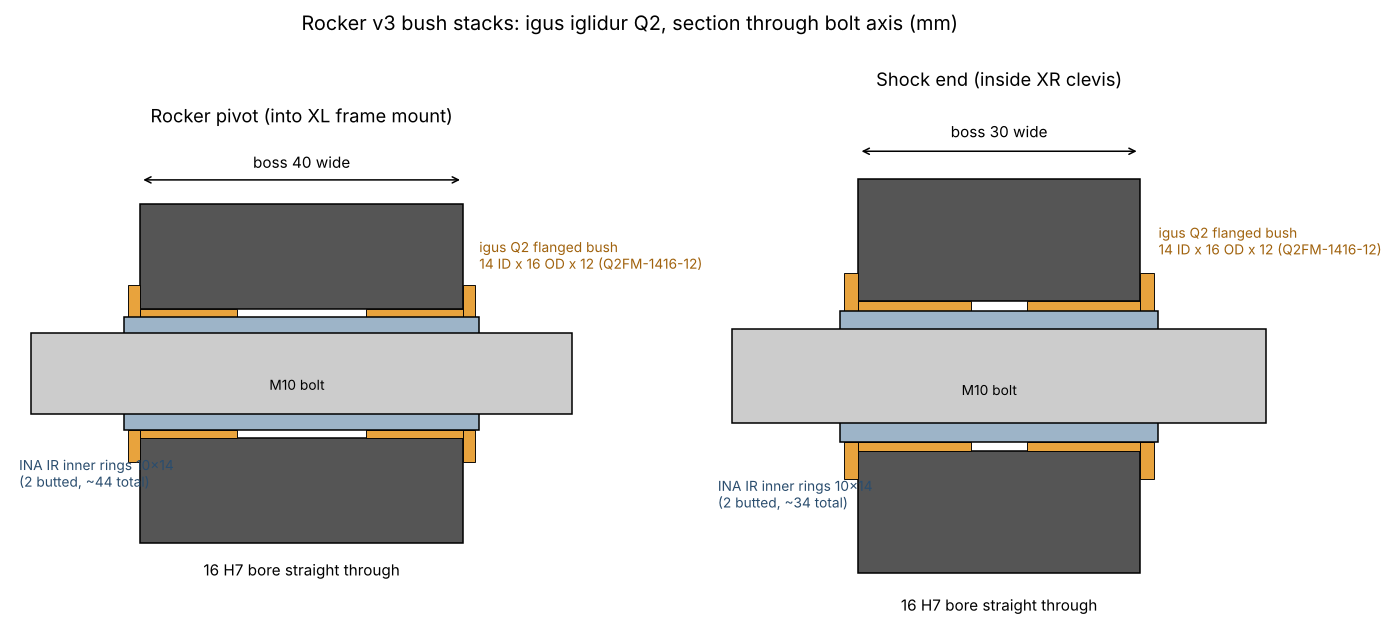
files/rocker-c/rocker-joel-v3-bush-stacks.png
