Blevo66/chassis-bench/files/rocker-c/rocker-joel-v3-windows-clean.png

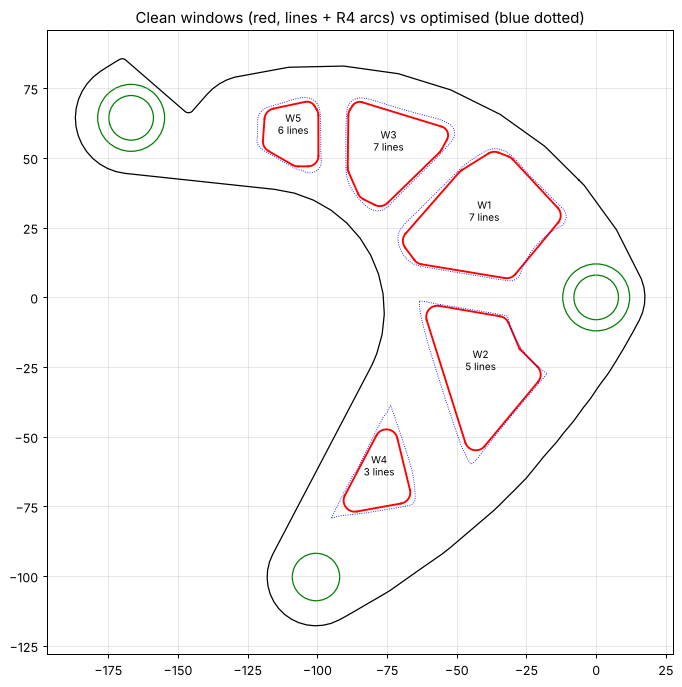
files/rocker-c/rocker-joel-v3-windows-clean.png
