Blevo66/chassis-bench/files/rocker-c/rocker-joel-v4-15slot-3d-stress.png

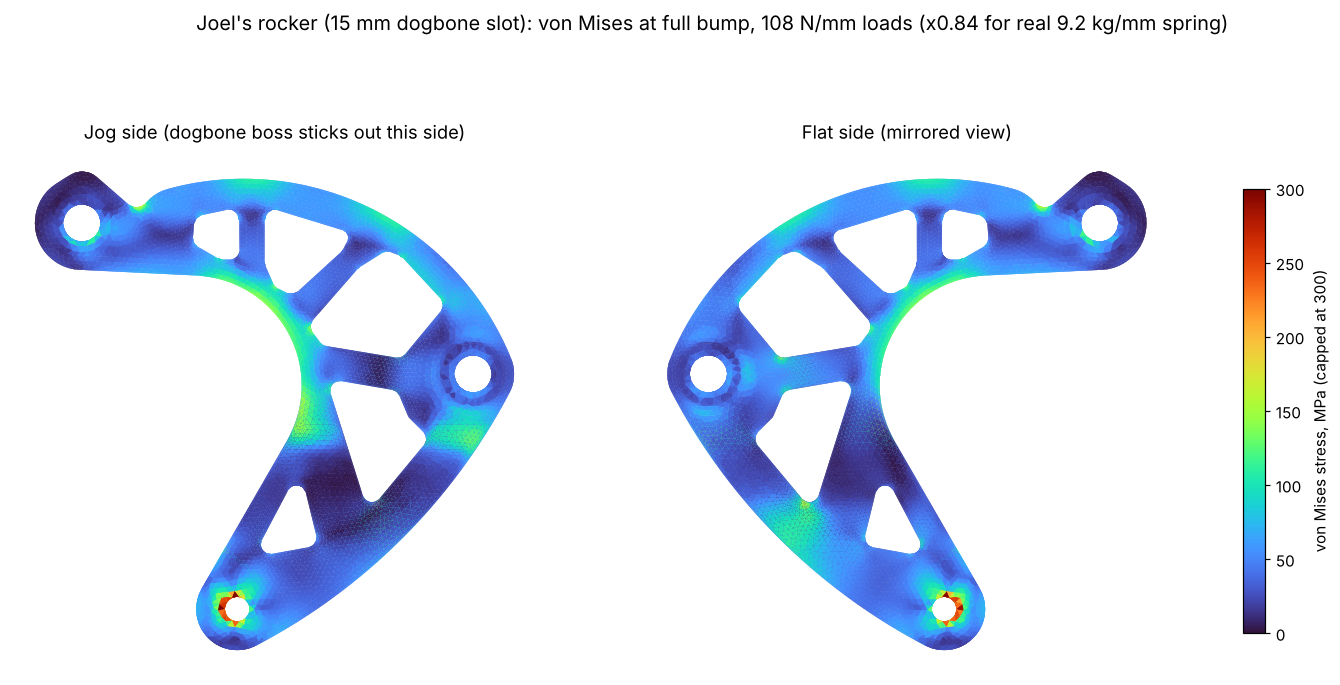
files/rocker-c/rocker-joel-v4-15slot-3d-stress.png
