Blevo66/chassis-bench/files/rocker-c/rocker-m-dimensions.png

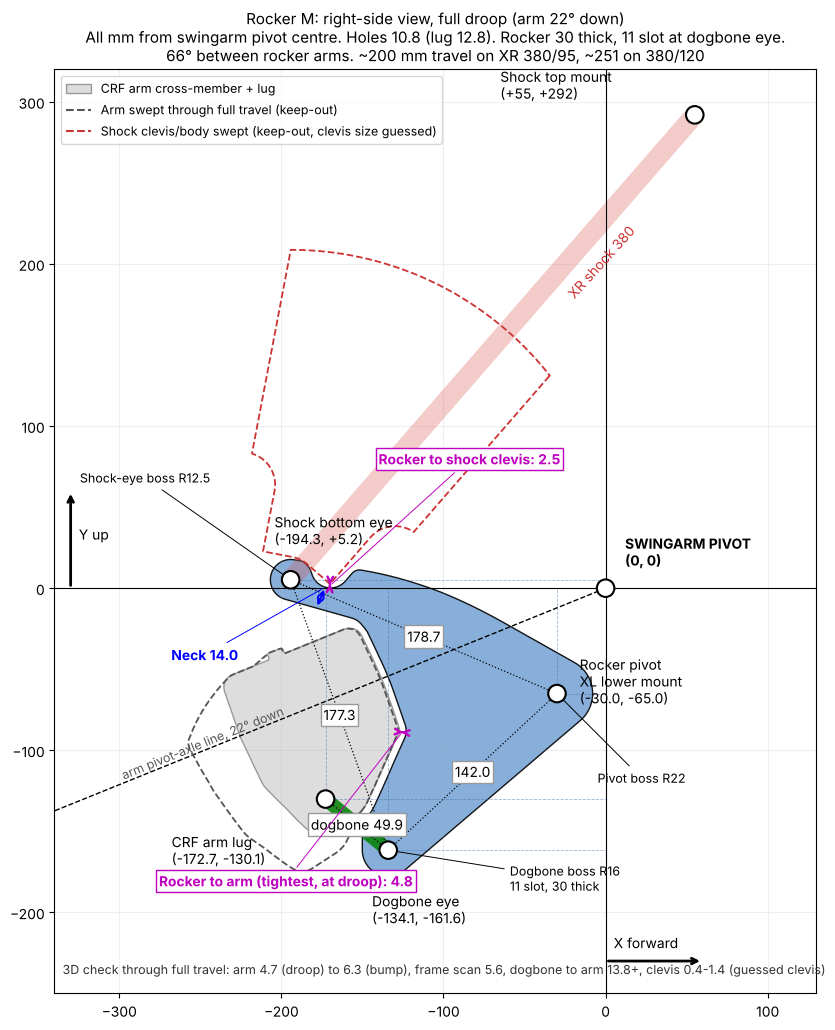
files/rocker-c/rocker-m-dimensions.png
