Blevo66/chassis-bench/files/rocker-c/rocker-m-drawing.png

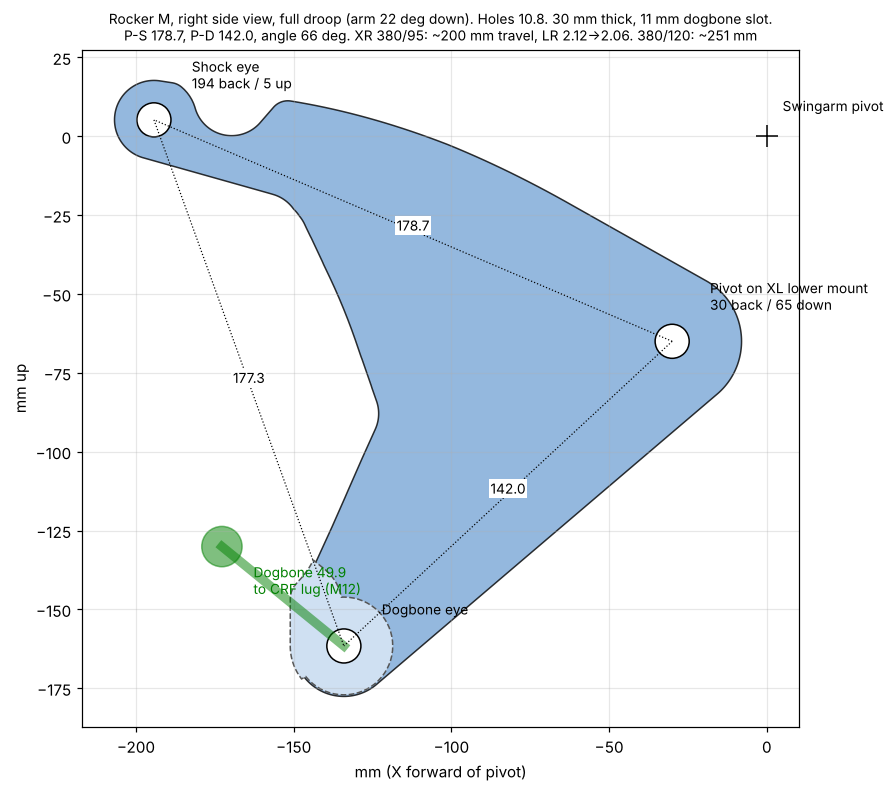
files/rocker-c/rocker-m-drawing.png
