Blevo66/chassis-bench/files/rocker-c/rocker-m-joel-stress.png

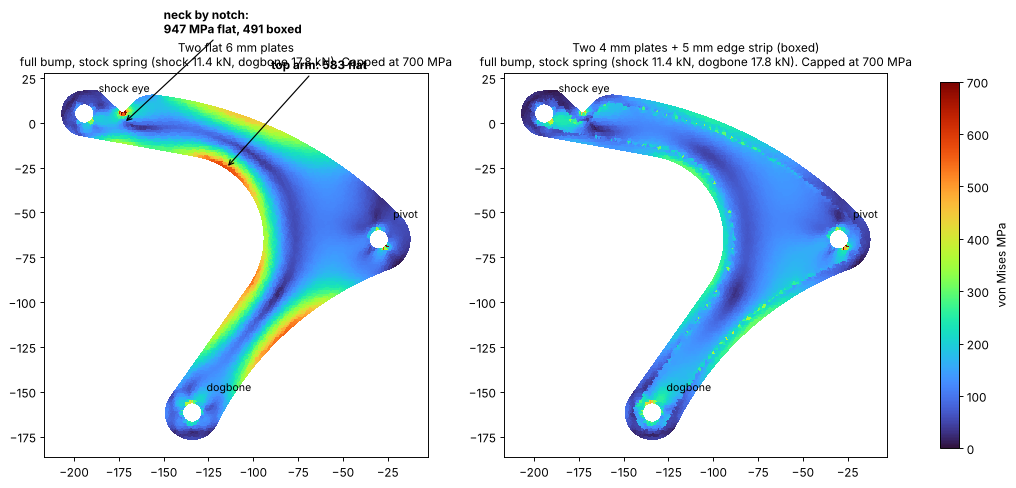
files/rocker-c/rocker-m-joel-stress.png
