Blevo66/chassis-bench/files/rocker-c/shorter-arm-options.png

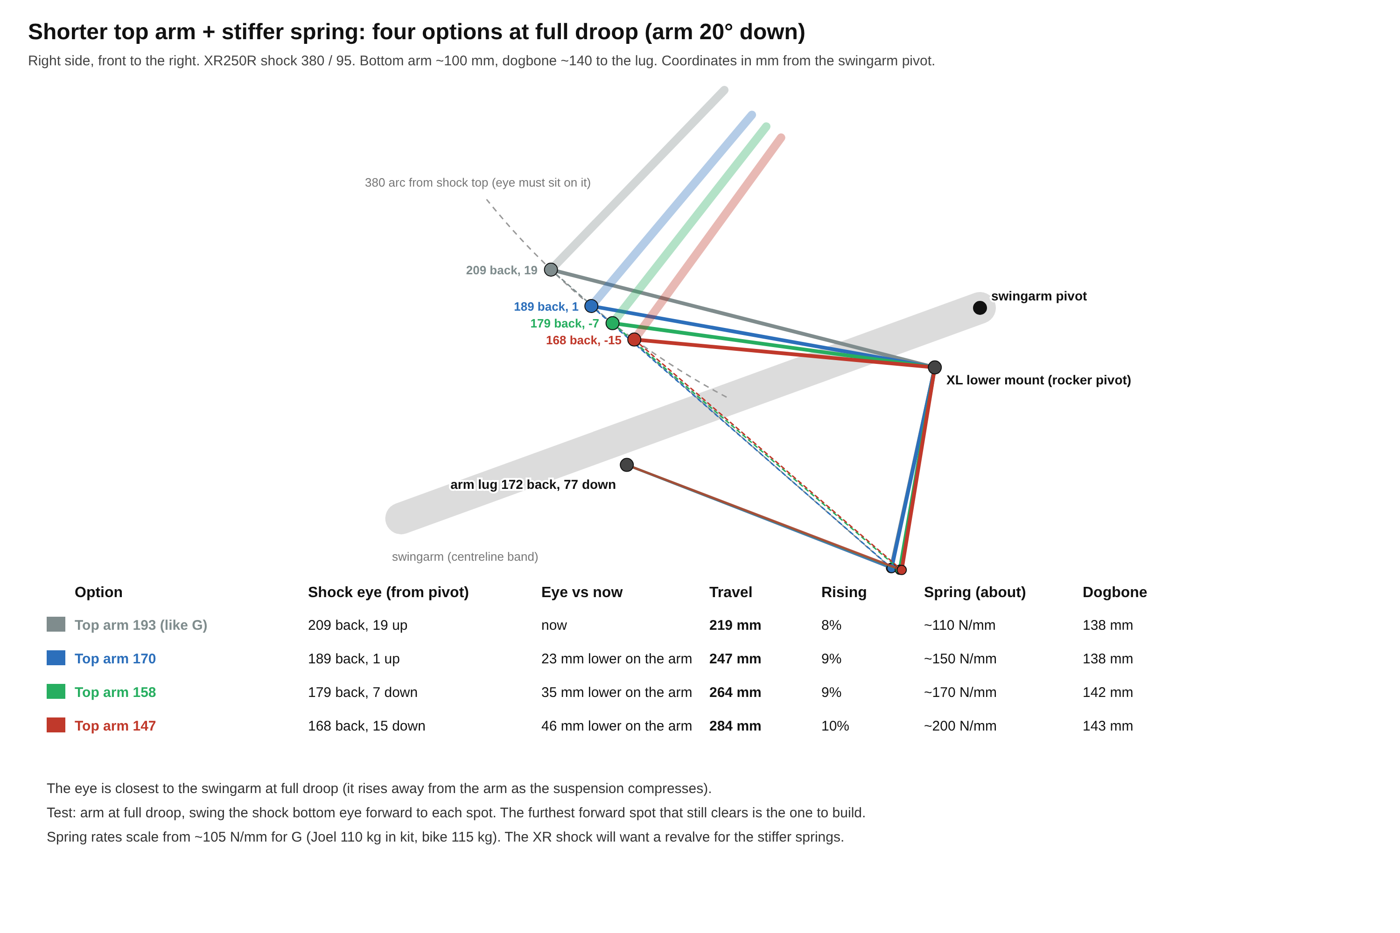
files/rocker-c/shorter-arm-options.png
