Blevo66/chassis-bench/files/rocker-c/t-linkage-check.png

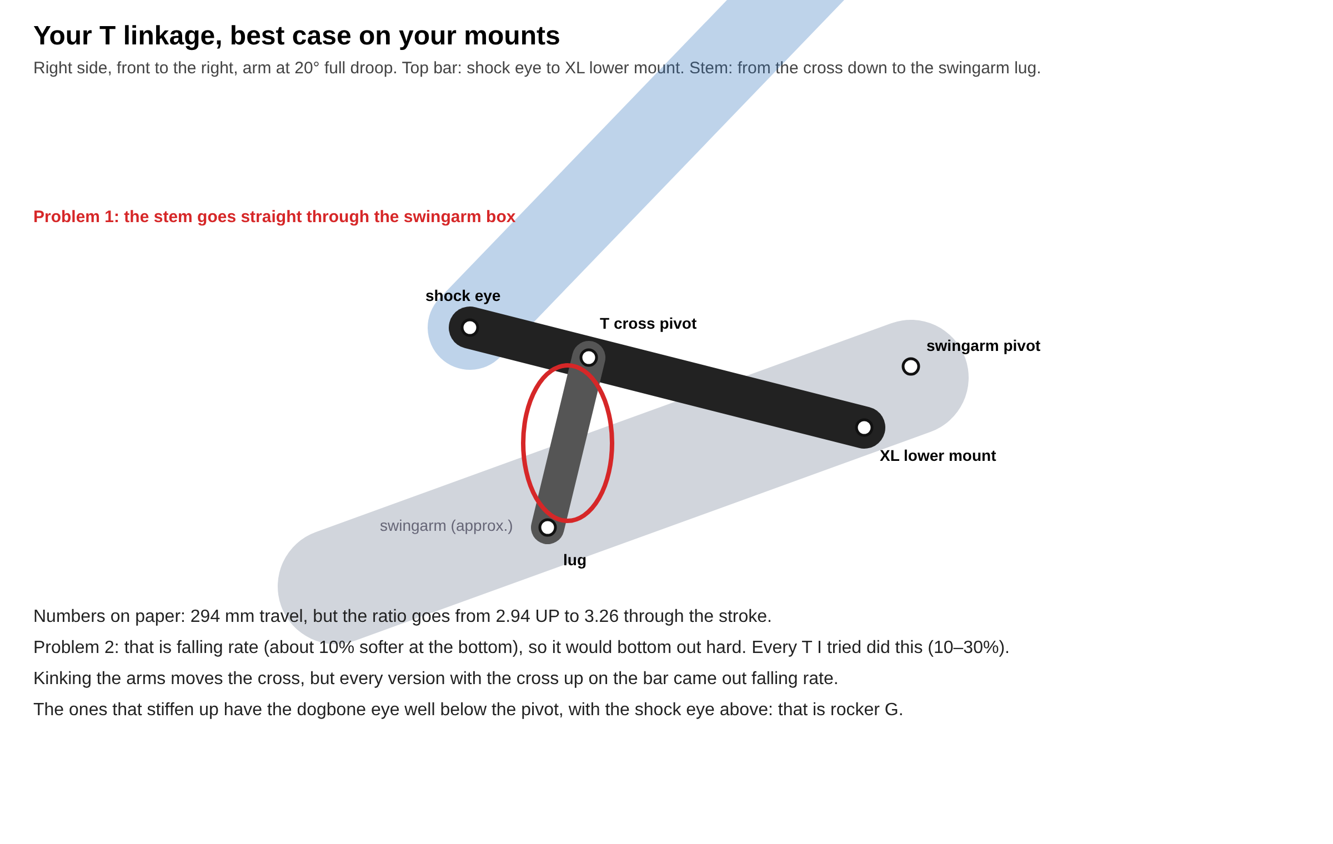
files/rocker-c/t-linkage-check.png
