Blevo66/chassis-bench/files/linkage/linkage-B-sag-in-frame.stl

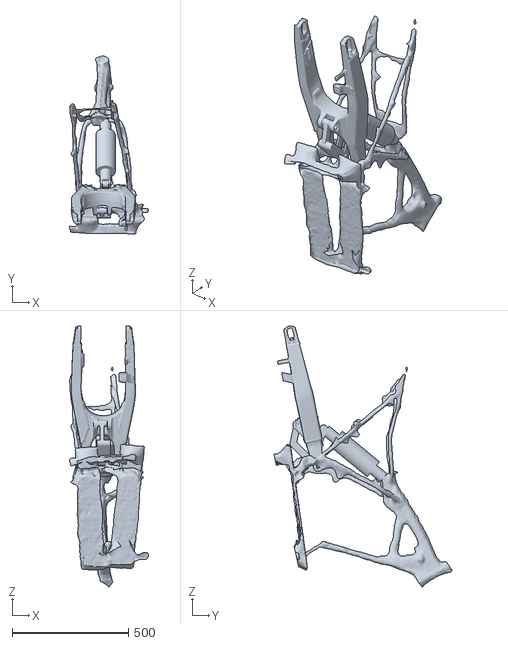
[picture p58: CAD file, 2026-10-29]
files/linkage/linkage-B-sag-in-frame.stl
341.9 x 768.0 x 1124.7
