Blevo66/chassis-bench/files/rocker-c/rocker-h-print/rocker-h-strong-30mm-slotted.stl

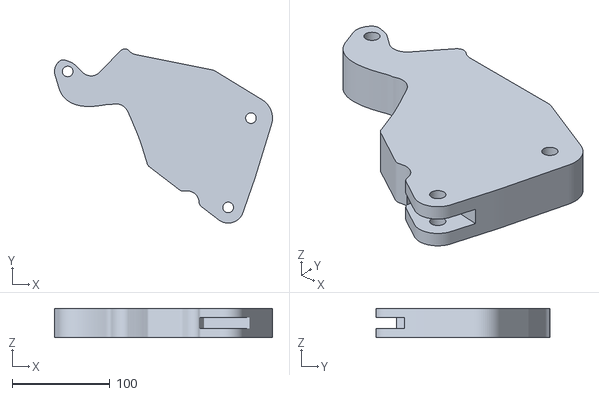
[picture p59: CAD file, 2026-11-06]
files/rocker-c/rocker-h-print/rocker-h-strong-30mm-slotted.stl
222.5 x 177.8 x 30.0
