Blevo66/chassis-bench/files/rocker-c/rocker-joel-v4-15slot.step

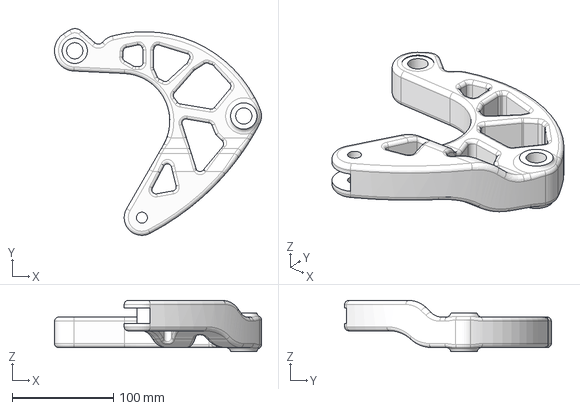
[picture p60: CAD file, 2026-11-11]
files/rocker-c/rocker-joel-v4-15slot.step
204.3 x 204.0 x 50.5 mm
