Blevo66/chassis-bench/files/rocker-c/rocker-m-print/rocker-m-30mm-slotted.stl

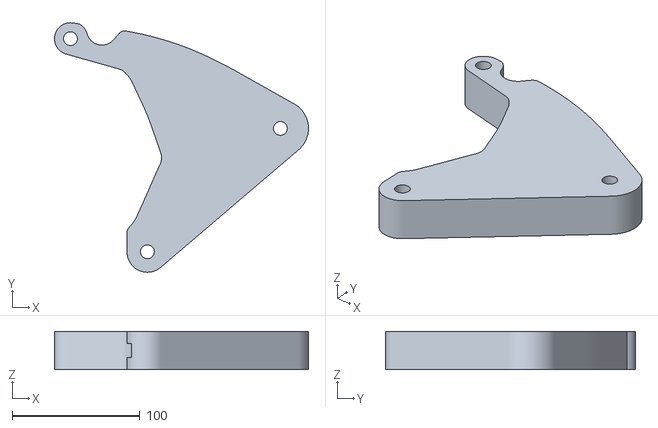
[picture p61: CAD file, 2026-11-06]
files/rocker-c/rocker-m-print/rocker-m-30mm-slotted.stl
198.8 x 195.3 x 30.0
