Blevo66/chassis-bench/files/rocker-c/rocker-h-print/rocker-h-smooth-30mm-slotted.stl

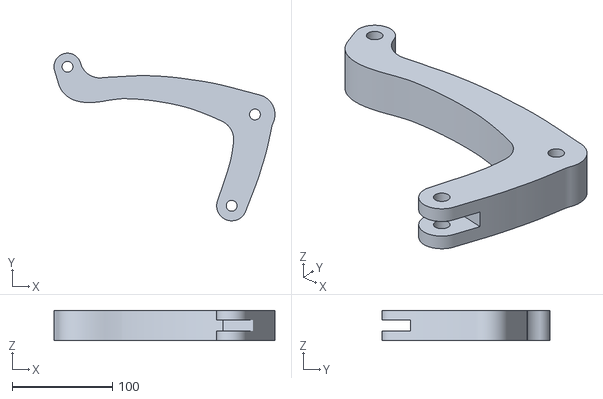
[picture p62: CAD file, 2026-11-06]
files/rocker-c/rocker-h-print/rocker-h-smooth-30mm-slotted.stl
220.5 x 167.2 x 30.0
