Blevo66/chassis-bench/files/rocker-c/rocker-joel-v3-windows-clean.dxf

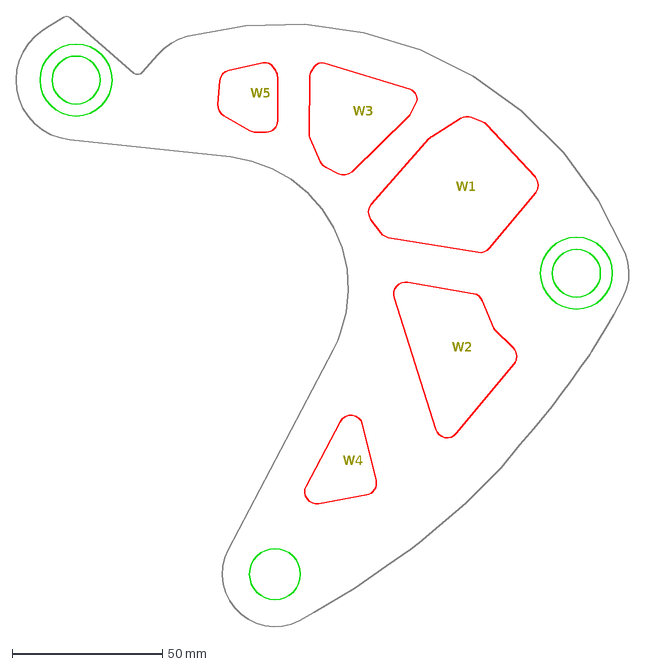
[picture p63: CAD file, 2026-11-11]
files/rocker-c/rocker-joel-v3-windows-clean.dxf
W1
W2
W3
W4
W5
