Blevo66/chassis-bench/files/rocker-c/rocker-m-print/dogbone-54-10mm.stl

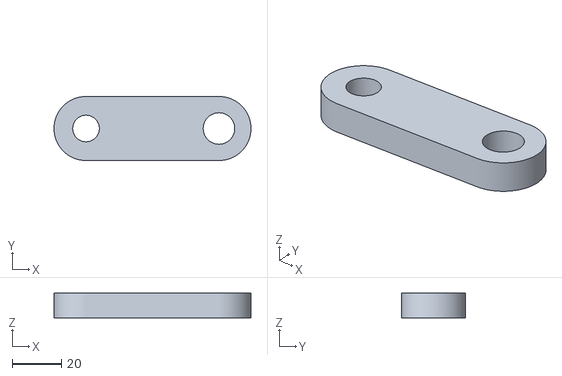
[picture p64: CAD file, 2026-11-06]
files/rocker-c/rocker-m-print/dogbone-54-10mm.stl
80.0 x 26.0 x 10.0
