Blevo66/chassis-bench/files/linkage/linkage-B-parts-only.stl

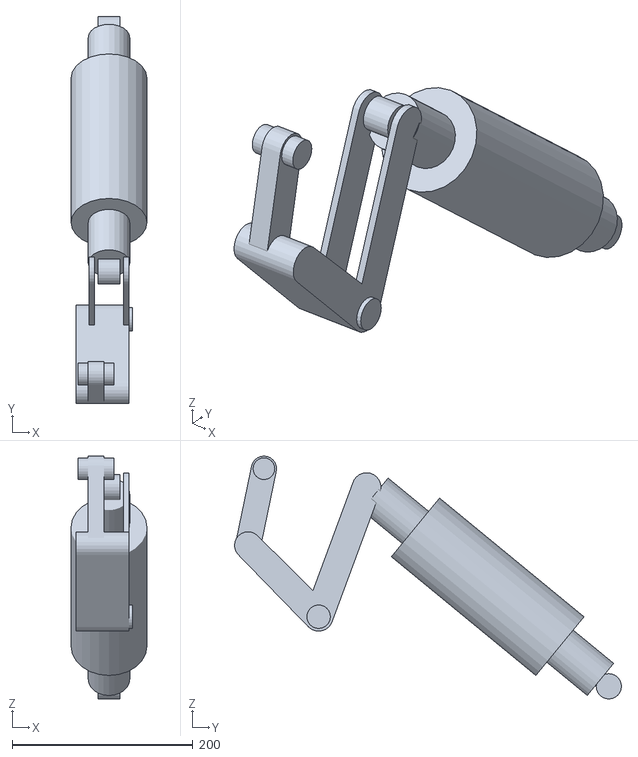
[picture p65: CAD file, 2026-10-29]
files/linkage/linkage-B-parts-only.stl
84.0 x 428.1 x 268.7
