Blevo66/chassis-bench/files/rocker-c/rocker-h-print/dogbone-132-12mm.stl

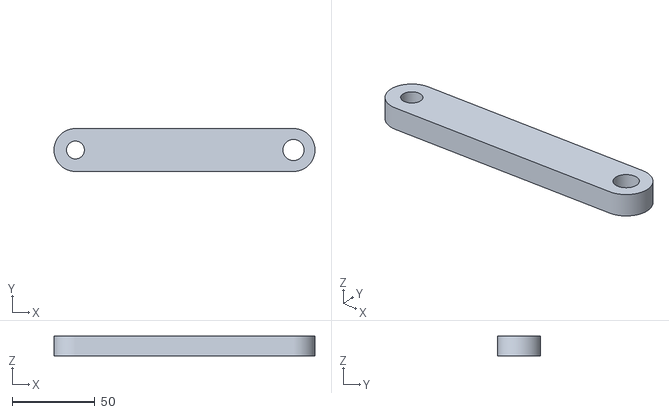
[picture p66: CAD file, 2026-11-06]
files/rocker-c/rocker-h-print/dogbone-132-12mm.stl
158.0 x 26.0 x 12.0
