Blevo66/chassis-bench/files/rocker-c/rocker-joel-v3-windows.dxf

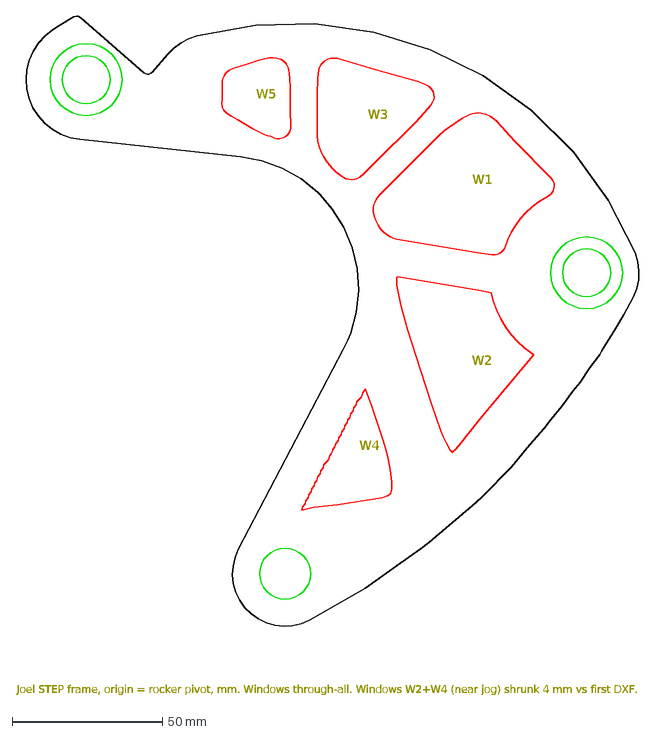
[picture p67: CAD file, 2026-11-11]
files/rocker-c/rocker-joel-v3-windows.dxf
W1
W2
W3
W4
W5
Joel STEP frame, origin = rocker pivot, mm. Windows through-all. Windows W2+W4 (near jog) shrunk 4 mm vs first DXF.
