Blevo66/chassis-bench/files/rocker-c/rocker-m-print/dogbone-50-10mm.stl

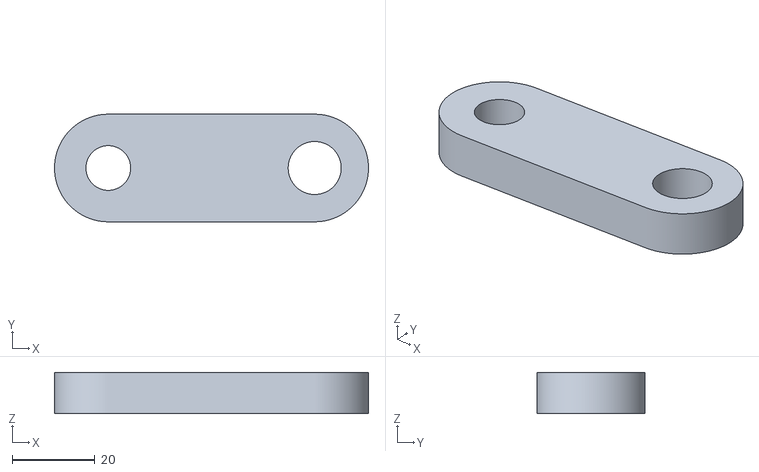
[picture p68: CAD file, 2026-11-06]
files/rocker-c/rocker-m-print/dogbone-50-10mm.stl
75.9 x 26.0 x 10.0
