Blevo66/chassis-bench/files/linkage/linkage-A-parts-only.stl

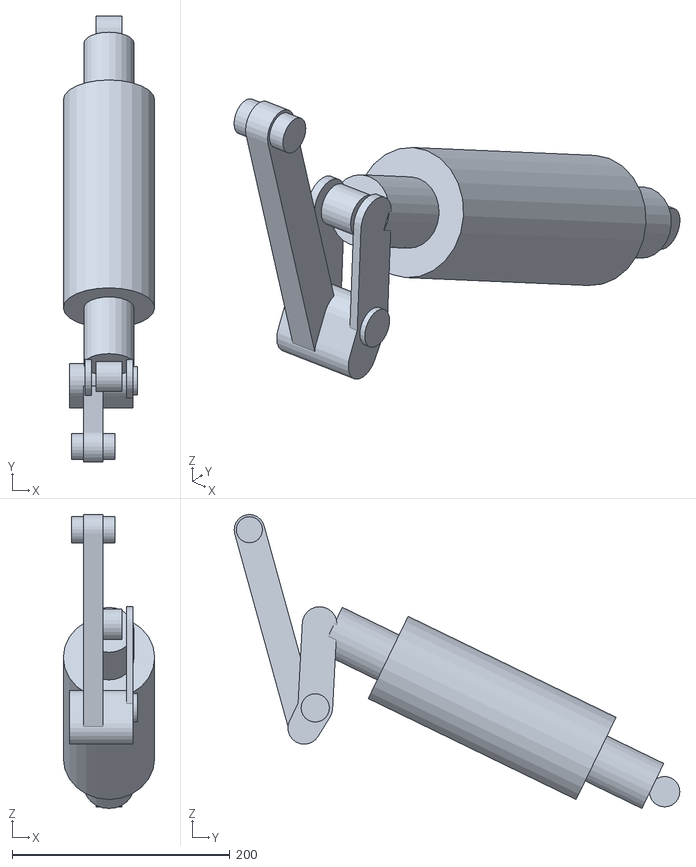
[picture p69: CAD file, 2026-10-29]
files/linkage/linkage-A-parts-only.stl
84.0 x 409.5 x 270.2
