Blevo66/chassis-bench/files/rocker-c/rocker-h-print/dogbone-132-10mm.stl

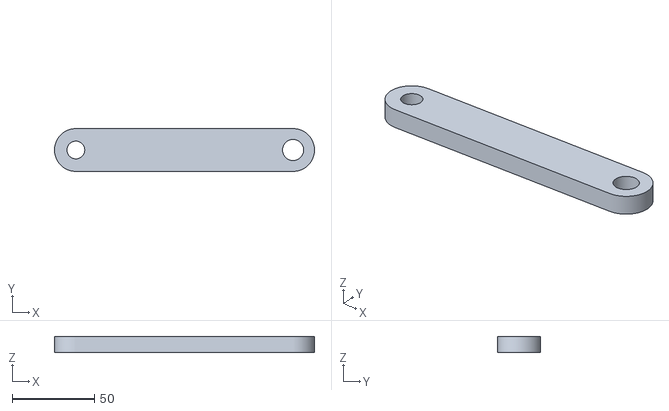
[picture p70: CAD file, 2026-11-06]
files/rocker-c/rocker-h-print/dogbone-132-10mm.stl
158.0 x 26.0 x 10.0
