Blevo66/chassis-bench/files/rocker-c/rocker-joel-v3-igus.step

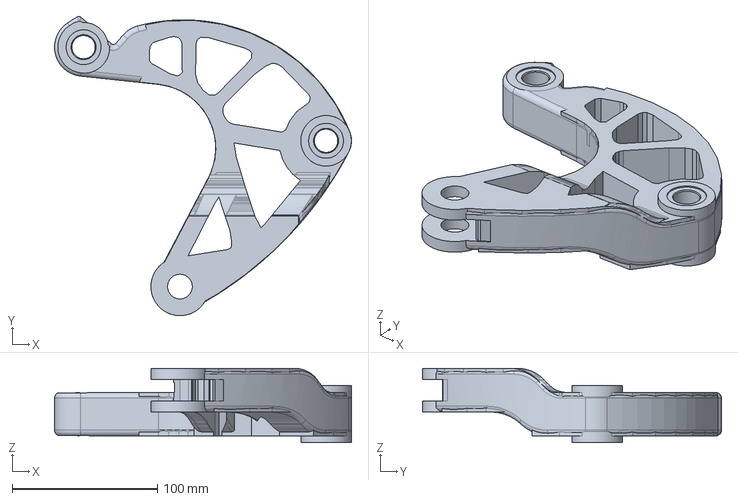
[picture p71: CAD file, 2026-11-11]
files/rocker-c/rocker-joel-v3-igus.step
204.3 x 205.9 x 51.1 mm
