Blevo66/chassis-bench/files/rocker-c/rocker-m-print/spacer-pivot-5mm-x2.stl

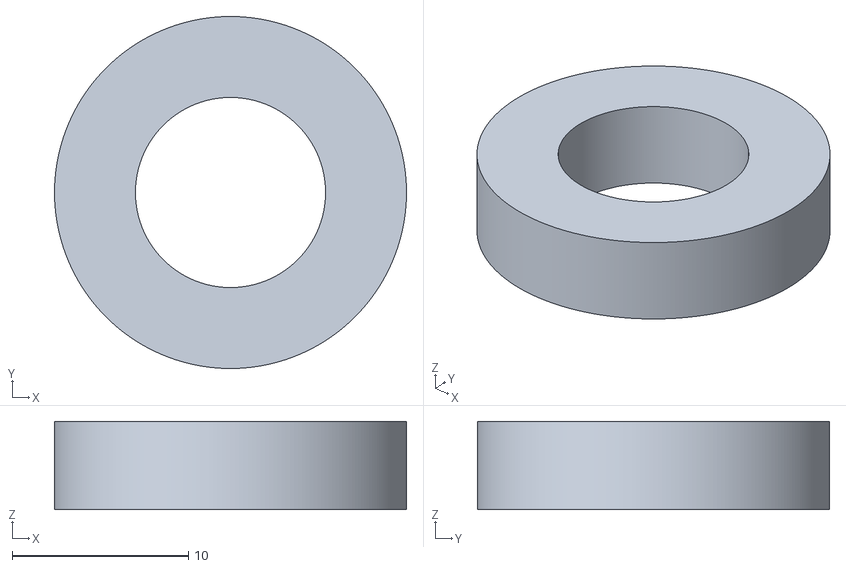
[picture p72: CAD file, 2026-11-06]
files/rocker-c/rocker-m-print/spacer-pivot-5mm-x2.stl
20.0 x 20.0 x 5.00
