Blevo66/chassis-bench/files/rocker-c/rocker-joel-v2.step

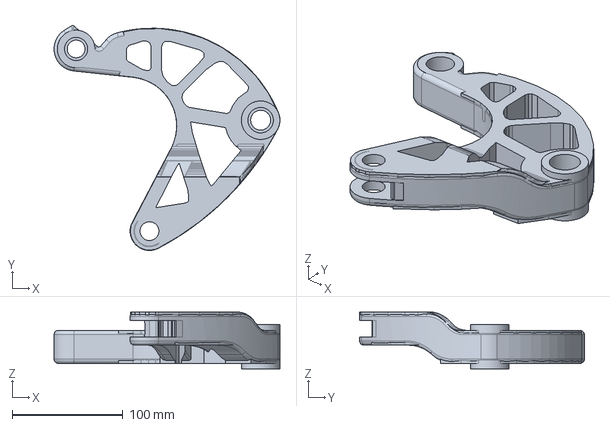
[picture p73: CAD file, 2026-11-11]
files/rocker-c/rocker-joel-v2.step
204.3 x 203.4 x 51.5 mm
