Blevo66/chassis-bench/files/rocker-c/rocker-m-print/dogbone-46-10mm.stl

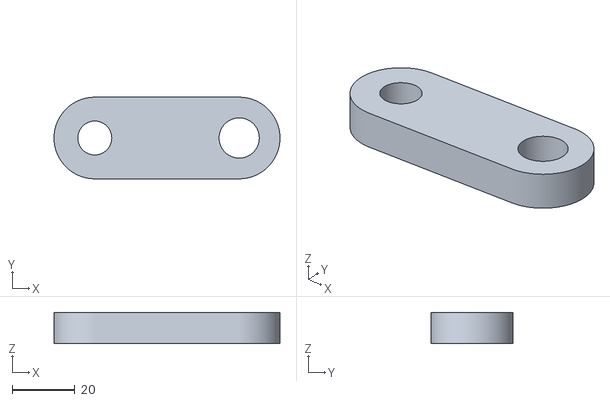
[picture p74: CAD file, 2026-11-06]
files/rocker-c/rocker-m-print/dogbone-46-10mm.stl
72.0 x 26.0 x 10.0
