Blevo66/chassis-bench/files/rocker-c/rocker-joel-optimised-clean.step

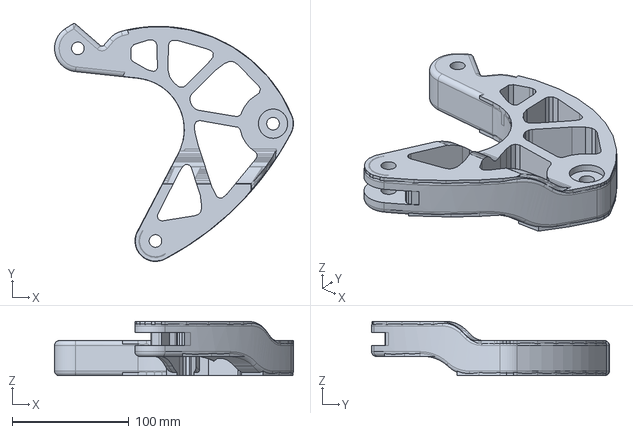
[picture p75: CAD file, 2026-11-11]
files/rocker-c/rocker-joel-optimised-clean.step
204.3 x 203.4 x 46.5 mm
