Blevo66/chassis-bench/files/rocker-c/rocker-m-print/spacer-lug-right-25.5mm.stl

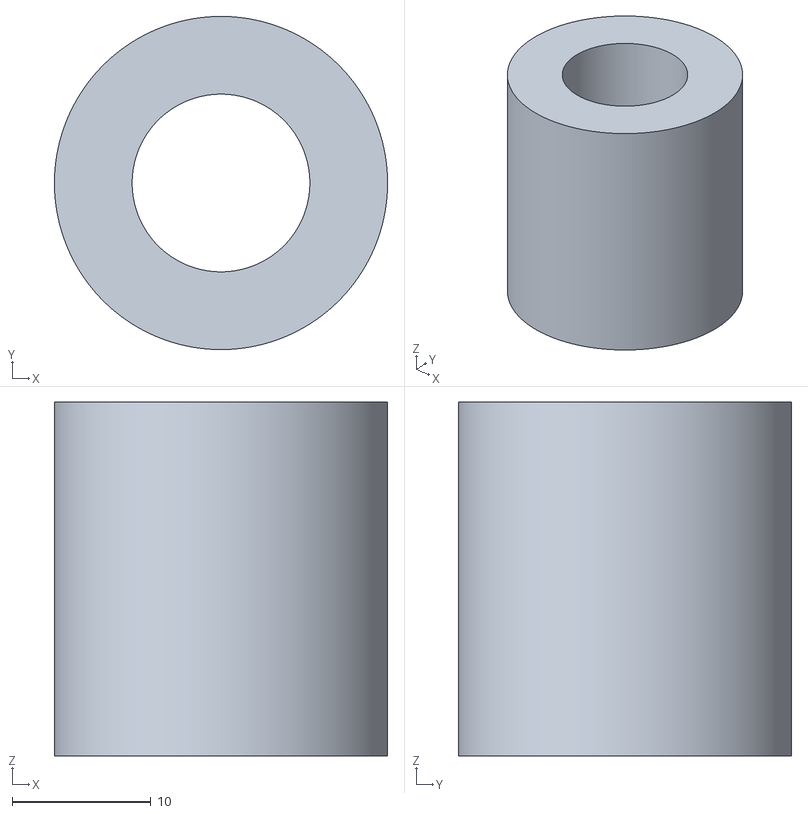
[picture p76: CAD file, 2026-11-06]
files/rocker-c/rocker-m-print/spacer-lug-right-25.5mm.stl
24.0 x 24.0 x 25.5
