Blevo66/chassis-bench/files/rocker-c/rocker-m-print/spacer-lug-left-5.5mm.stl

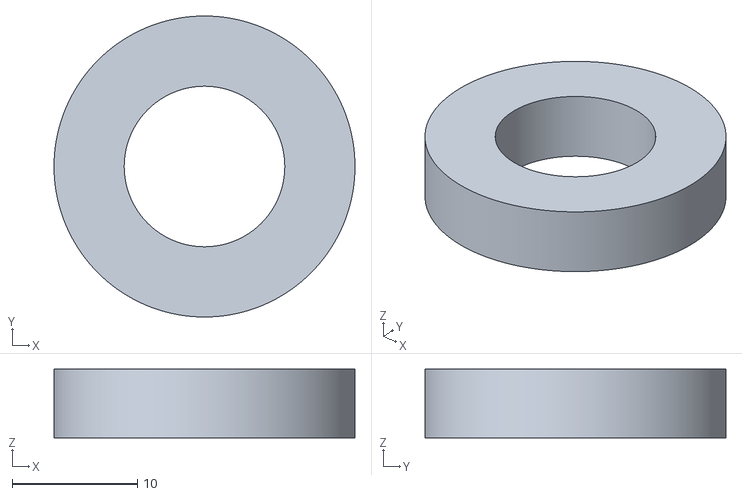
[picture p78: CAD file, 2026-11-06]
files/rocker-c/rocker-m-print/spacer-lug-left-5.5mm.stl
24.0 x 24.0 x 5.50
