Blevo66/chassis-bench/files/rocker-c/rocker-h-print/spacer-pivot-5mm-x2.stl

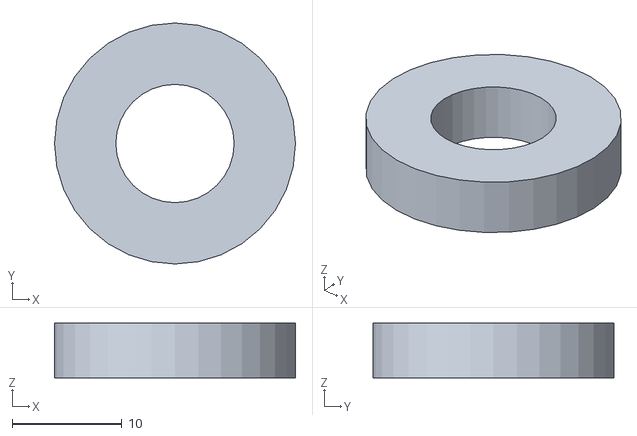
[picture p79: CAD file, 2026-11-06]
files/rocker-c/rocker-h-print/spacer-pivot-5mm-x2.stl
22.0 x 22.0 x 5.00
