Blevo66/chassis-bench/files/rocker-c/rocker-joel-optimised-windows.dxf

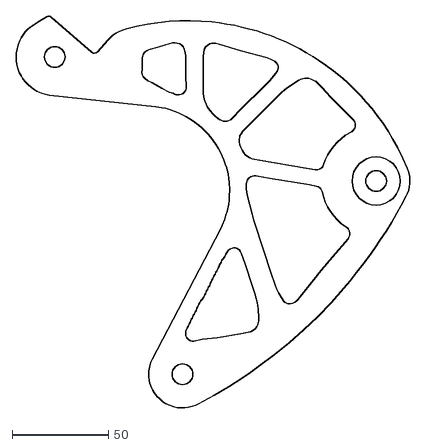
[picture p80: CAD file, 2026-11-11]
files/rocker-c/rocker-joel-optimised-windows.dxf
204.3 x 203.4
