Blevo66/chassis-bench/files/rocker-c/rocker-h-print/rocker-h-30mm-slotted.stl

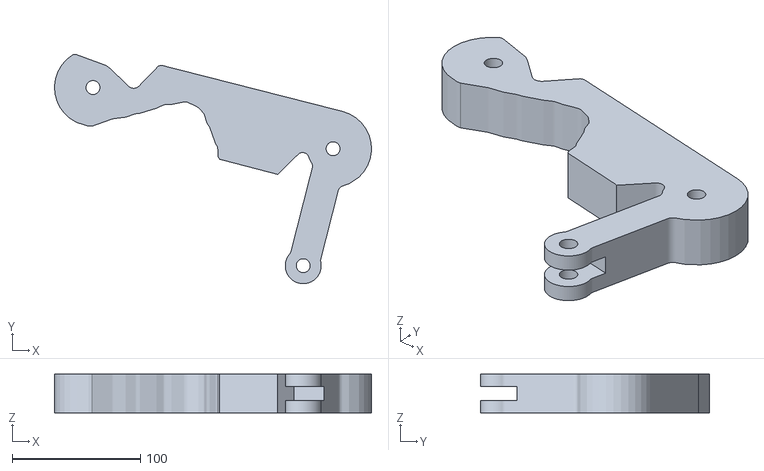
[picture p81: CAD file, 2026-11-06]
files/rocker-c/rocker-h-print/rocker-h-30mm-slotted.stl
246.9 x 178.6 x 30.0
