Blevo66/chassis-bench/files/rocker-c/rocker-m.dxf

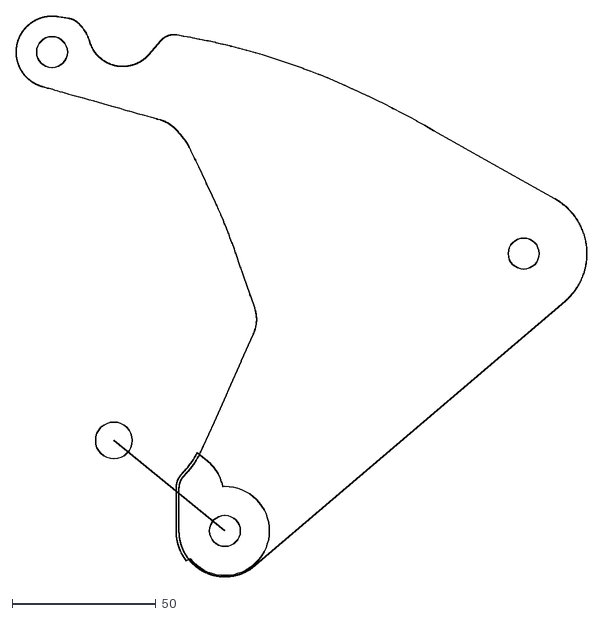
[picture p82: CAD file, 2026-11-06]
files/rocker-c/rocker-m.dxf
198.8 x 195.3
