Blevo66/chassis-bench/files/rocker-c/rocker-h-alloy.step

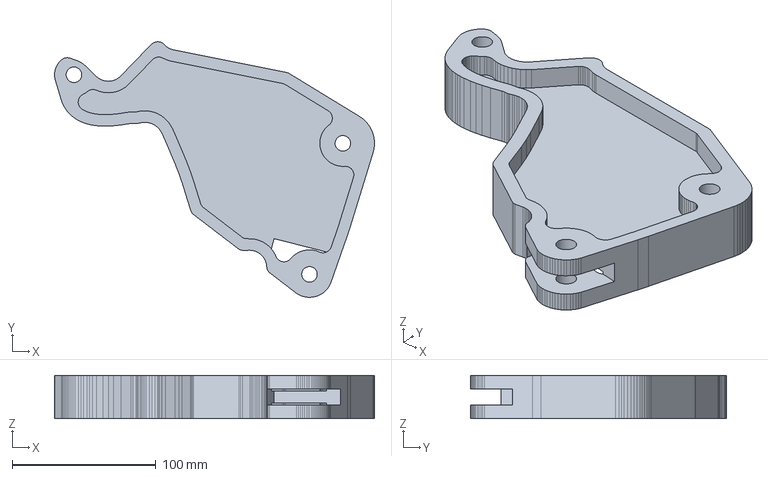
[picture p83: CAD file, 2026-11-06]
files/rocker-c/rocker-h-alloy.step
222.5 x 177.7 x 30.0 mm
