Blevo66/chassis-bench/files/rocker-c/rocker-h-print/rocker-h-16mm.stl

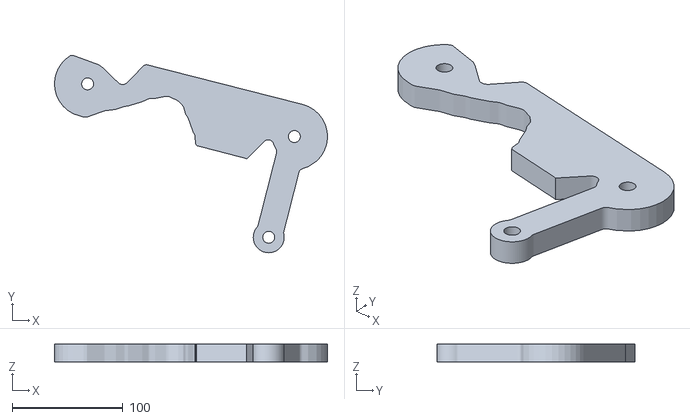
[picture p84: CAD file, 2026-11-06]
files/rocker-c/rocker-h-print/rocker-h-16mm.stl
246.9 x 178.6 x 16.0
