Blevo66/chassis-bench/files/rocker-c/rocker-h-strong-plate.dxf

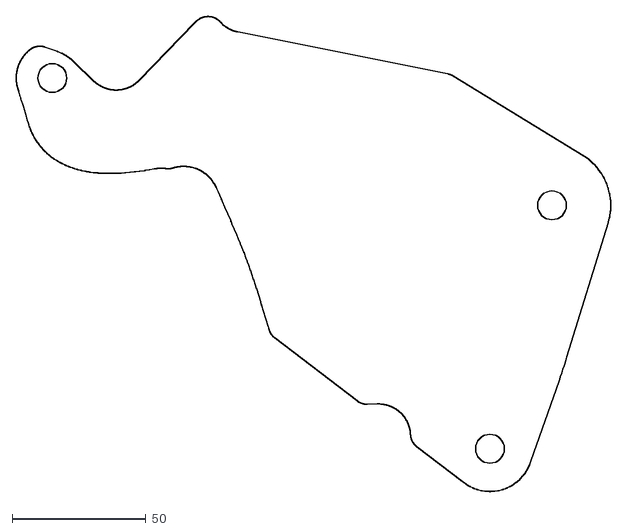
[picture p85: CAD file, 2026-11-06]
files/rocker-c/rocker-h-strong-plate.dxf
222.5 x 177.8
