Blevo66/chassis-bench/files/rocker-c/rocker-h-print/spacer-lug-left-18.5mm.stl

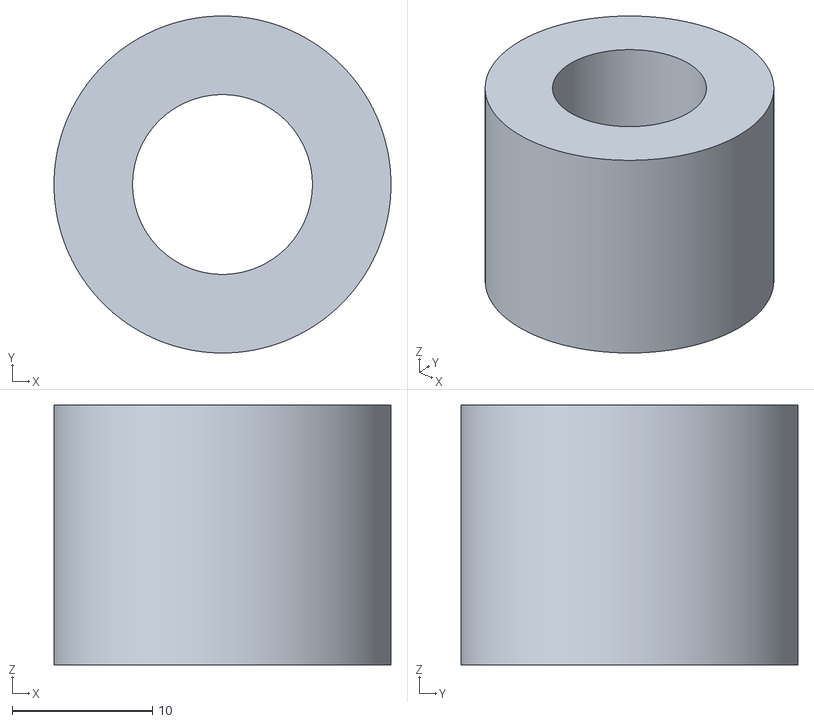
[picture p86: CAD file, 2026-11-06]
files/rocker-c/rocker-h-print/spacer-lug-left-18.5mm.stl
24.0 x 24.0 x 18.5
