Blevo66/chassis-bench/files/rocker-c/rocker-h-smooth.dxf

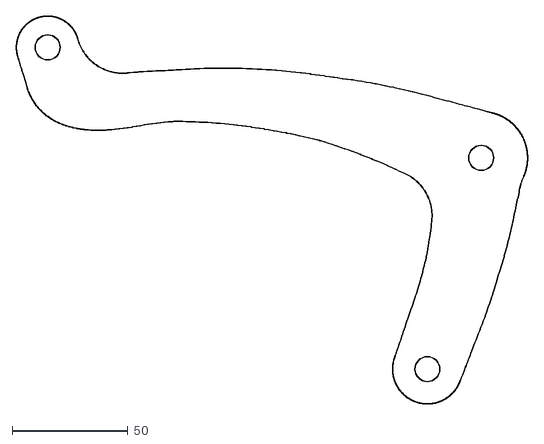
[picture p87: CAD file, 2026-11-06]
files/rocker-c/rocker-h-smooth.dxf
220.5 x 167.2
