Blevo66/chassis-bench/files/rocker-c/rocker-h-print/spacer-lug-right-10.5mm.stl

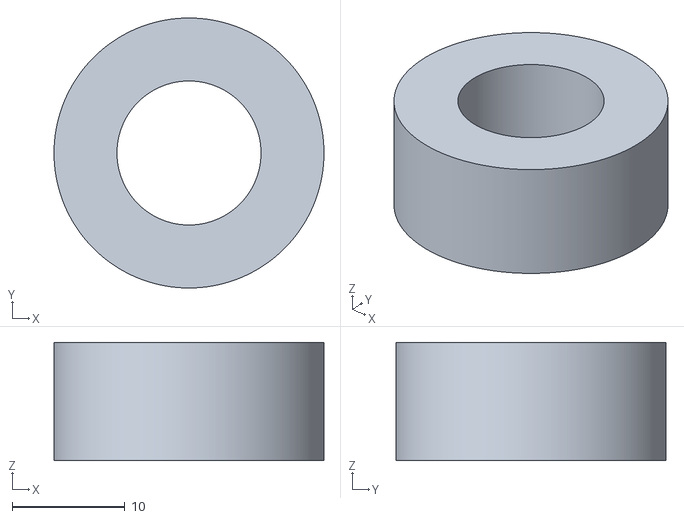
[picture p88: CAD file, 2026-11-06]
files/rocker-c/rocker-h-print/spacer-lug-right-10.5mm.stl
24.0 x 24.0 x 10.5
