Blevo66/chassis-bench/files/rocker-c/rocker-k.dxf

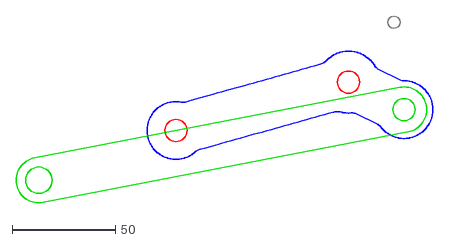
[picture p89: CAD file, 2026-11-05]
files/rocker-c/rocker-k.dxf
201.9 x 90.5
