Blevo66/chassis-bench/files/rocker-c/rocker-j.dxf

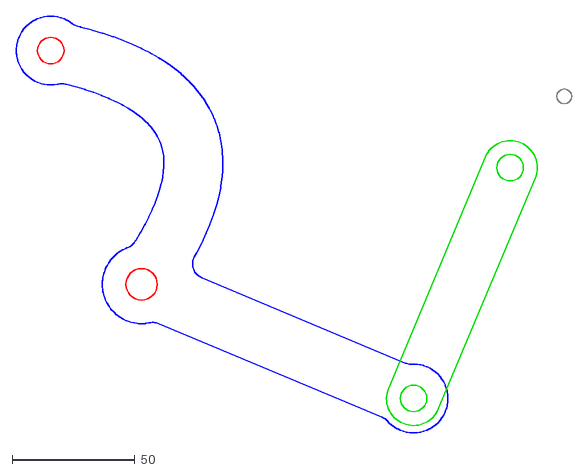
[picture p91: CAD file, 2026-11-05]
files/rocker-c/rocker-j.dxf
226.0 x 169.6
