Blevo66/chassis-bench/files/rocker-c/rocker-h-print/dogbone-130-12mm.stl

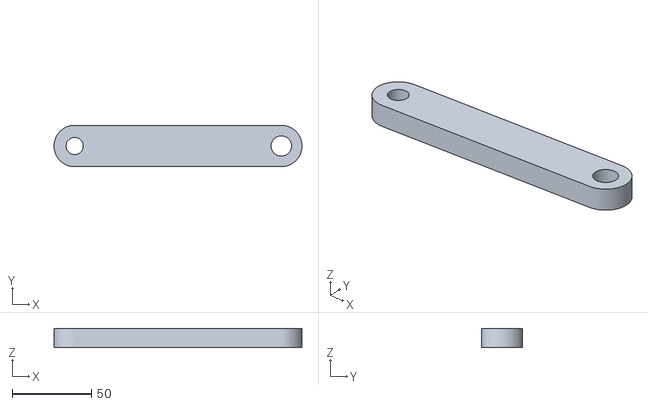
[picture p92: CAD file, 2026-11-06]
files/rocker-c/rocker-h-print/dogbone-130-12mm.stl
156.0 x 26.0 x 12.0
