Blevo66/chassis-bench/files/rocker-c/rocker-h.dxf

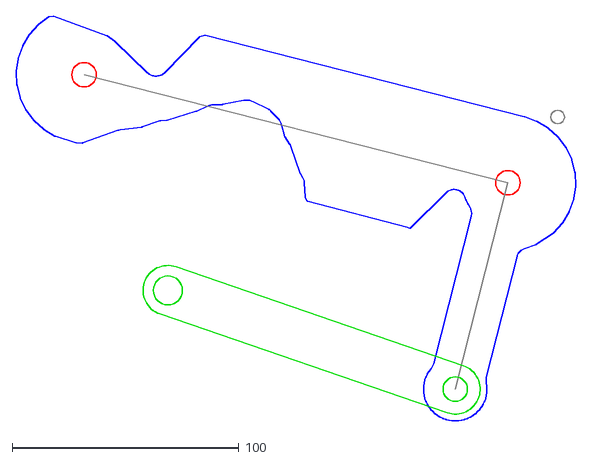
[picture p93: CAD file, 2026-11-04]
files/rocker-c/rocker-h.dxf
246.9 x 178.6
