Blevo66/chassis-bench/files/rocker-c/rocker-g.dxf

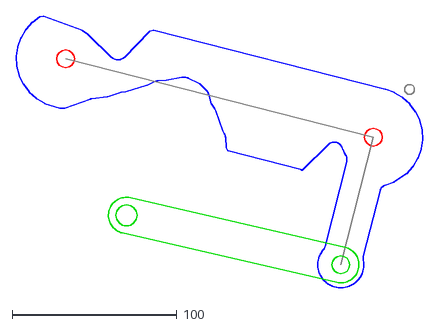
[picture p94: CAD file, 2026-11-04]
files/rocker-c/rocker-g.dxf
246.9 x 165.0
