Blevo66/chassis-bench/files/rocker-c/rocker-e.dxf

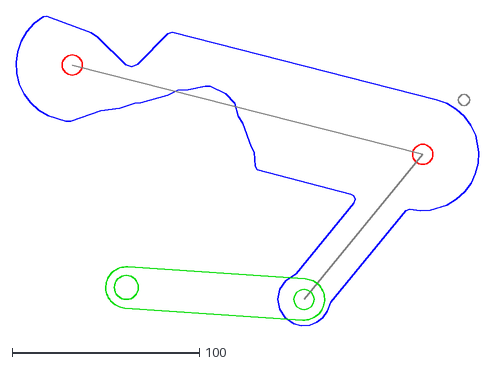
[picture p95: CAD file, 2026-11-04]
files/rocker-c/rocker-e.dxf
246.9 x 164.8
