Blevo66/chassis-bench/files/rocker-c/rocker-f.dxf

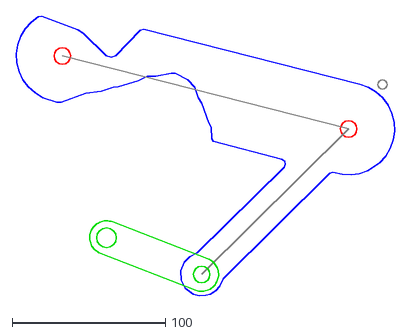
[picture p96: CAD file, 2026-11-04]
files/rocker-c/rocker-f.dxf
246.9 x 182.4
