Blevo66/chassis-bench/files/rocker-c/rocker-d.dxf

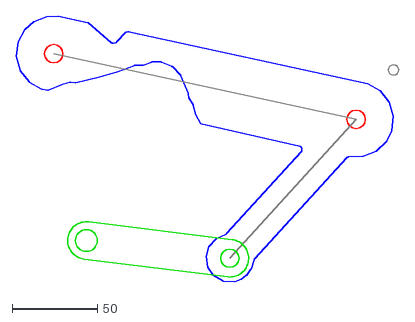
[picture p97: CAD file, 2026-11-03]
files/rocker-c/rocker-d.dxf
224.2 x 155.5
