Blevo66/chassis-bench/(list of files, cad)

Other CAD files:
files/linkage/linkage-A-sag-in-frame.stl
files/rocker-c/rocker-h-print/dogbone-130-10mm.stl
files/rocker-c/rocker-h-print/dogbone-138-10mm.stl
files/rocker-c/rocker-h-print/dogbone-134-10mm.stl
files/rocker-c/rocker-h-print/dogbone-134-12mm.stl
files/rocker-c/rocker-h-print/dogbone-138-12mm.stl
files/rocker-c/rocker-h-alloy.stl
