Blevo66/chassis-bench/files/rocker-c/rocker-m-print/README.md

# Rocker M mock-up print set (2026-11-06)

Frame rocker on the XL lower mount (30 back / 65 down from the swingarm pivot), short dogbone to the CRF250 arm lug (CAD position). Full droop is designed at 22 deg. XR250R shock 380/95 with the stock spring.

- Shock bottom eye at full droop: about 194 mm behind and 5 mm above the swingarm pivot (about 194 mm in a straight line).
- XR 380/95: about 200 mm wheel travel, leverage 2.12 -> 2.06 (gentle 3% rise).
- Custom 380/120 later: about 251 mm with the same rocker.
- Rocker: P-S 178.7, P-D 142.0, S-D 177.3, 66 deg. Dogbone 49.9 centres.

| File | Print | Notes |
|---|---|---|
| rocker-m-30mm-slotted.stl | 1 | 30 mm thick, holes 10.8 (M10), 11 mm slot at the dogbone eye. About 199 x 195 mm, lies flat |
| dogbone-50-10mm.stl | 1 | 49.9 centres. Rocker end 10.8, lug end 12.8 (M12) |
| dogbone-46 / 54 | optional | Test lengths |
| spacer-pivot-5mm-x2.stl | 2 | Centres the 30 mm rocker in the 40 mm XL mount |
| spacer-lug-left-5.5mm.stl, spacer-lug-right-25.5mm.stl | 1 each | Same as rocker H |

Drawing: ../rocker-m-drawing.png. 1:1 DXF: ../rocker-m.dxf (origin swingarm pivot, X forward, Y up, full droop, layers ROCKER / HOLES / SLOT / DOGBONE).

Model clearances through travel: swingarm 4.7 mm at droop to 6.3 at bump, frame scan 5.6, dogbone to arm 14+, shock clevis 0.4 to 1.4 (clevis shape is a guess, so check this one first).

Mock-up only: fine to sit the bike on its wheels, not to ride or sit on.
