Blevo66/chassis-bench/files/sketches/bike-sketch-sheets-guides.pdf

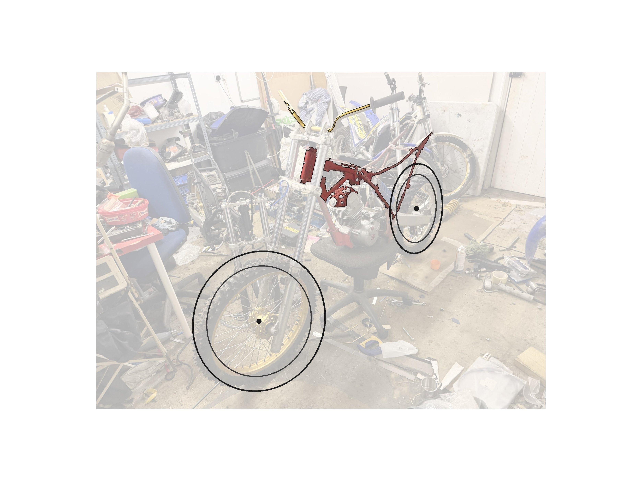
[picture p98: page 1]
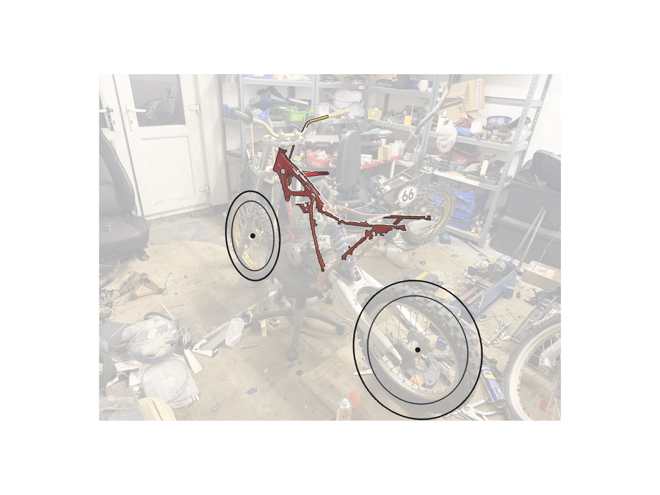
[picture p99: page 2]
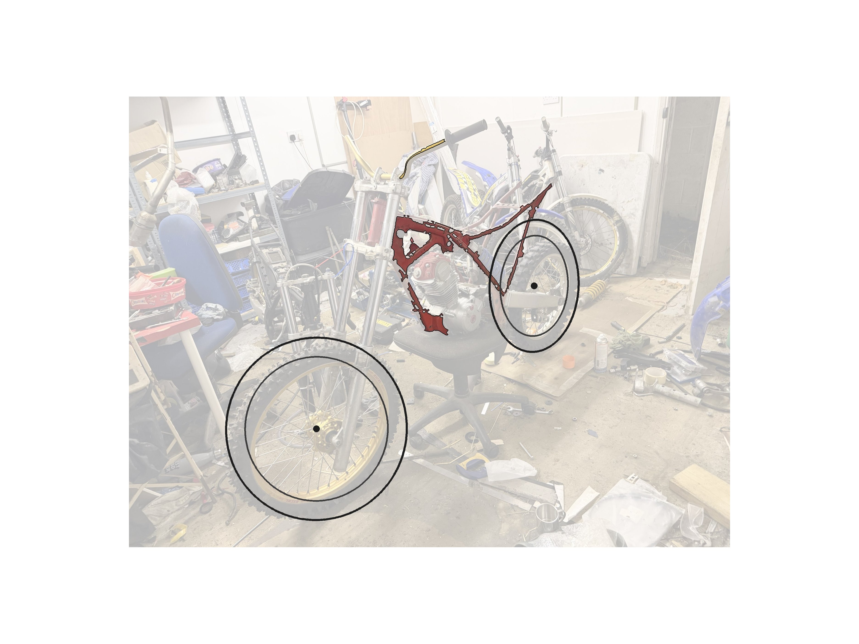
[picture p100: page 3]
