Blevo66/chassis-bench/files/rocker-c/rocker-d-print.png

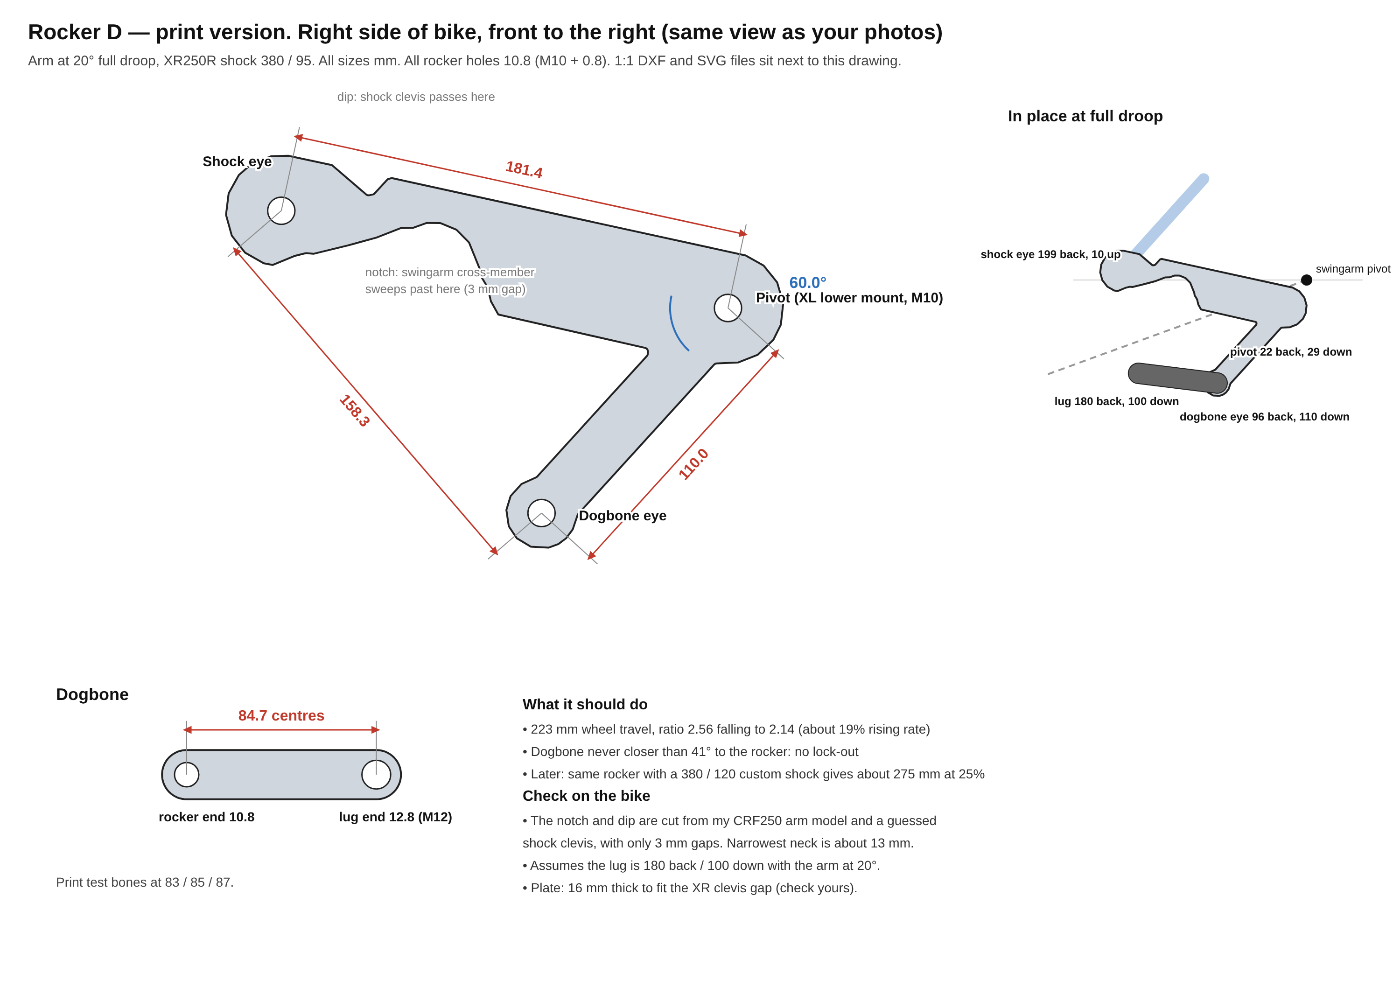
files/rocker-c/rocker-d-print.png
