Blevo66/chassis-bench/files/rocker-c/rocker-e-print.png

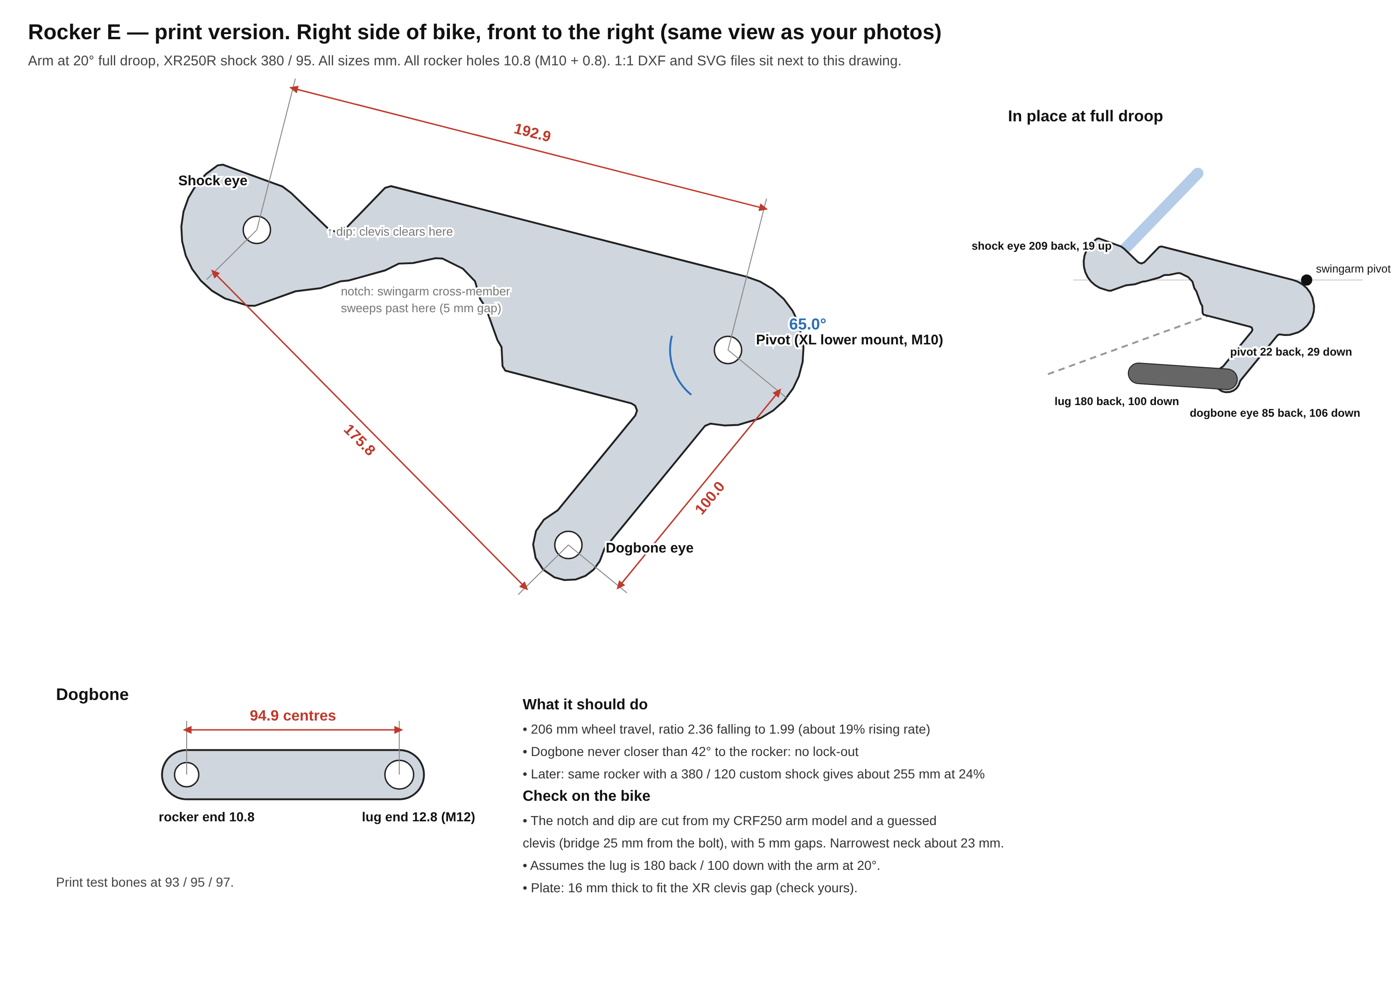
files/rocker-c/rocker-e-print.png
