Blevo66/chassis-bench/files/rocker-c/rocker-g-print.png

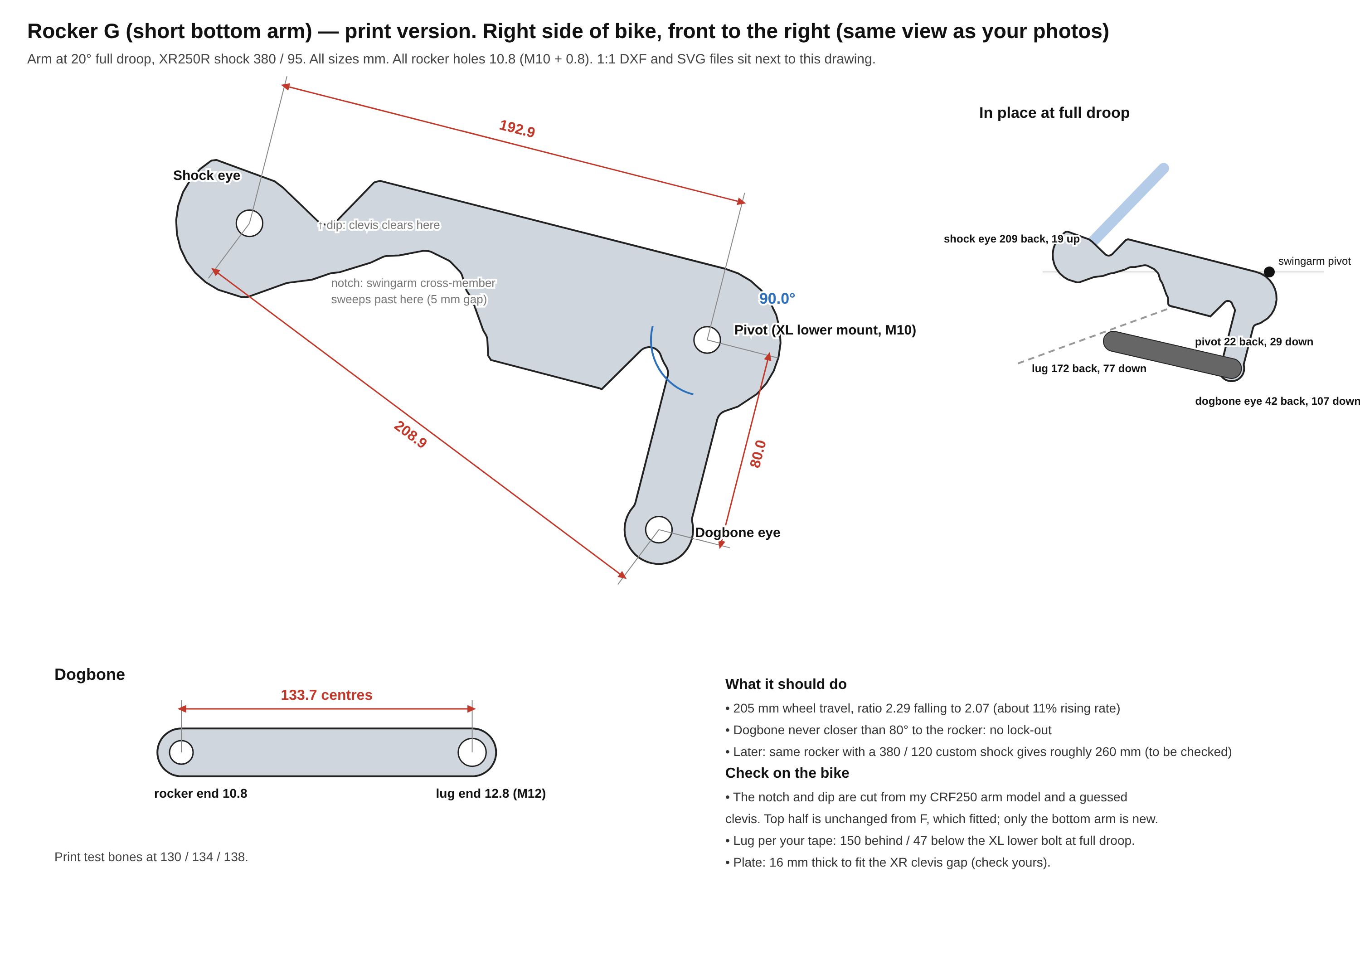
files/rocker-c/rocker-g-print.png
