Blevo66/chassis-bench/files/rocker-c/rocker-j-print.png

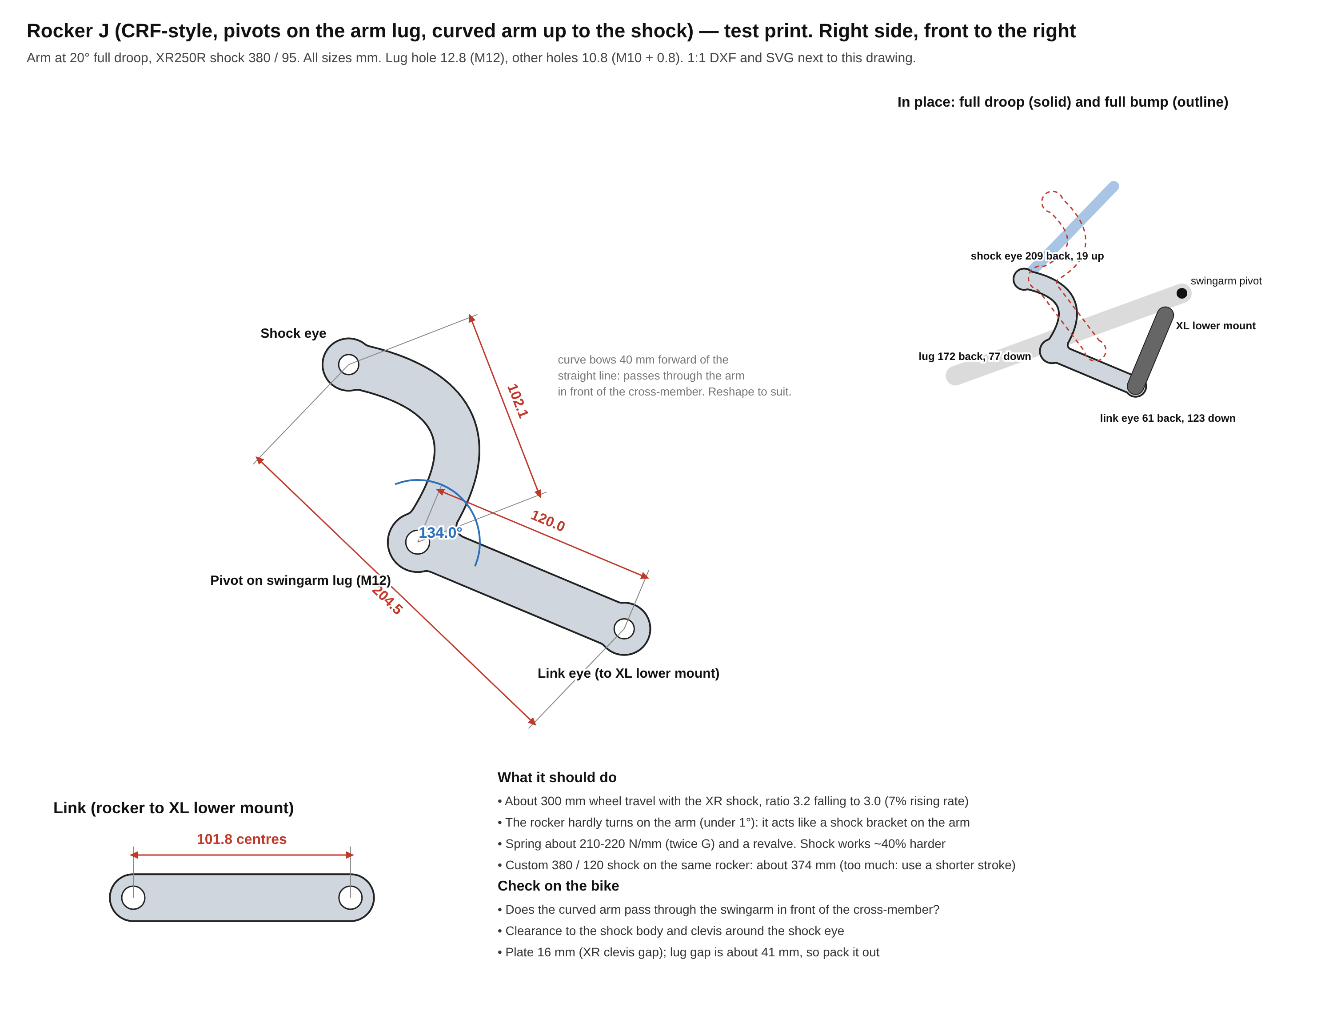
files/rocker-c/rocker-j-print.png
