Blevo66/chassis-bench/files/rocker-c/rocker-k-print.png

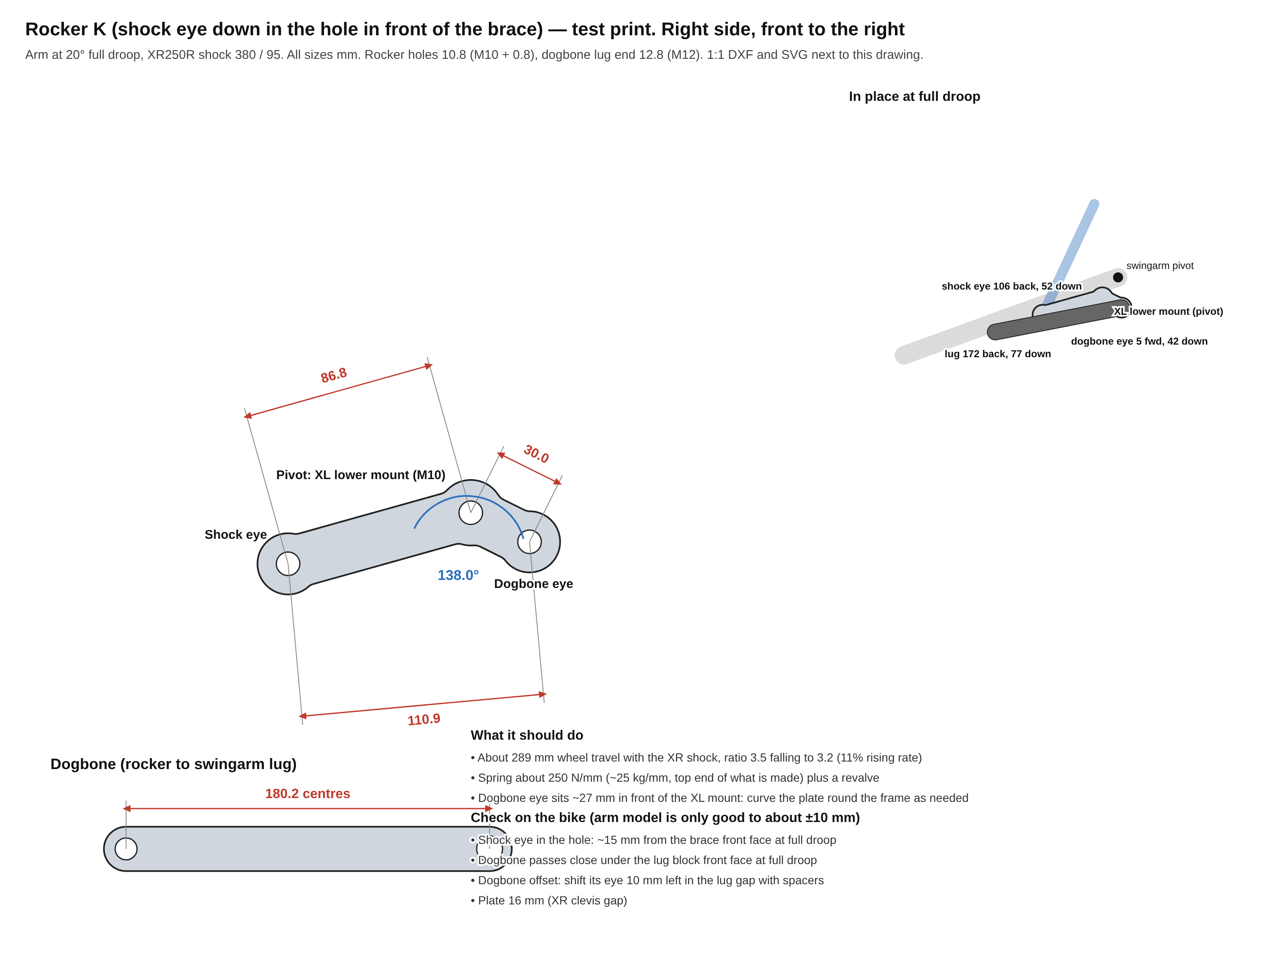
files/rocker-c/rocker-k-print.png
