Blevo66/chassis-bench/(commit log)

2026-10-12 Add the Chassis Bench as an installable offline web app
    Claude-Session: https://claude.ai/code/session_01XjcangeqEtEtsah4SatimV
2026-10-12 Pin the side view while scrolling
    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
2026-10-12 Add a tick box to pin or unpin the side view
    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
2026-10-12 Shrink the bike in the home-screen icon so the whole frame shows
    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
2026-10-12 Make the sliders follow the finger inside the pinned side view
    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
2026-10-12 Add measuring mode: a guided laser walk-round that fills in the bench
    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
2026-10-12 Split measuring mode into parts: frame, swingarm, shock, dogbone and forks
    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
2026-10-12 Measuring mode: bare-frame setup, rocker pivot measured on the swingarm itself
    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
2026-10-12 Measuring mode: level the bottom frame rails
    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
2026-10-12 Open cradle frame: no lower rails; level the seat rails when measuring
    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
2026-10-12 Add a CRF style tab: '02-03 CRF450 rocker hung under the arm
    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
2026-10-12 Stock XL linkage: C-shaped rocker (arm at the top, dogbone at the bottom, shock in the middle)
    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
2026-10-13 Note the measured 10 mm left offset of the shock top and dogbone mount
    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
2026-10-13 Add a step-by-step swingarm and linkage measuring guide (arm.html) that sends its results back as a bench link
    The bench opens a #m= link straight into measuring mode's review, ready to apply.
    The service worker now caches each page under its own URL so the guide can't replace the bench offline.
    Claude-Session: https://claude.ai/code/session_011x9ecXt5ubRpHej58z3d9D
2026-10-13 Measuring guide: much simpler, 7 short steps, no string
    The rocker bolt is found from two hole-to-hole distances (to the pivot and to the axle);
    the page works out its position along and above the pivot-to-axle line for the bench.
    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
2026-10-13 Measuring guide: show the worked-out rocker bolt position (along and height) in the results
    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
2026-10-13 Swingarm & linkage calculator: generic wording, parts and years box, pivot width and rocker mount offset and width
    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
2026-10-13 Swingarm & linkage calculator: rocker mount inside width (gap between the lugs)
    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
2026-10-13 Defaults from the mock-up: fork stack 260 mm, footpeg 125 mm below the pivot
    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
2026-10-19 CRF style tab: never leave the side view blank
    A blank or broken number saved on the phone (null/NaN) made the linkage
    fail to assemble, which wiped the drawing. Put defaults back for any such
    number on load, offer a one-tap 'put back the linkage guesses' button when
    the linkage won't assemble, and show a message instead of a blank view if
    drawing ever throws.
    Claude-Session: https://claude.ai/code/session_01BvER1VrEYyCGq1FZqVcGXA
2026-10-19 Add a 'Put everything back to default' button
    Resets the frame and all three tabs (padlocks too) after a confirm, so a
    tab stuck with bad numbers can always be brought back.
    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
2026-10-19 Reset button puts just the tab you're on back to default
    Replaces 'Put everything back to default' (Joel wants only the current
    tab reset). Padlocks on that tab are reset too; other tabs and the shared
    frame numbers are left alone.
    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
2026-10-19 CRF style: custom dogbone to the XL's own lower mount
    Joel's plan is a CRF arm and rocker with a custom dogbone forward to the
    existing XL lower mount. The CRF tab now uses the frame's dogbone mount
    (same as Build, filled in by measuring mode), with the rocker spot,
    dogbone (145 mm) and shock (450 mm) refitted: 277 mm travel, ratio 4.4
    to 3.1, arm 4.5 deg at rider sag. Saved CRF tabs on the old made-up lug
    move across unless locked.
    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
2026-10-19 Add the rocker & dogbone designer page, linked from the bench (#1)
    Put in the swingarm, frame mounts, shock and the angle it runs at, plus the travel
    and rising rate wanted; it searches for a rocker and dogbone that give them, shows
    the side view and leverage curve, lists the numbers for the bench's CRF style tab,
    and makes STL files for a full-size dog-leg rocker and dogbone mock-up.
    Claude-Session: https://claude.ai/code/session_01CnXFxULnkKD7HPT8qDq9j1
2026-10-19 Make the rocker designer link look like a button (#2)
    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
2026-10-19 Rocker designer: take the mounts and shock from the Chassis Bench (#3)
    Reads the bench's saved tab (CRF style by default) from the same browser
    storage: arm length, rocker pivot, shock top, dogbone mount, shock length
    and stroke, plus the arm and shock angles where the bench's linkage tops out.
    Kept in step on every open until a linked number is changed here.
    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
2026-10-19 Rocker designer: let it find the shock angle, stay clear of over centre, add a through-the-arm tab (#4)
    Changing the shock length with the angle fixed moved the shock eye so far that
    the only rockers left sat at the over-centre limit. The shock angle can now be
    searched over a range, the default minimum dogbone-to-rocker angle goes from
    30 to 40 degrees with a strong pull towards 55, and results that miss the
    targets say so plainly. A second tab designs an old Pro-Link style layout with
    the rocker on top of the arm and the shock eye above the arm's centreline.
    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
2026-10-19 Rocker designer: through-the-arm rocker pivots under the arm (shark's tooth) (#5)
    Joel corrected the layout: the rocker pivot and dogbone eye stay under the
    swingarm and the rocker points up through it, so only the shock eye sits
    above the centreline. The pivot comes from the bench again, the tab finds
    the shock length and angle, and misses now say which way to move things.
    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
2026-10-19 Rocker designer: drop the Chassis Bench pull-in, add padlocks to lock numbers (#6)
    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
2026-10-19 Rocker designer: spring rate, sag and wheel stiffness graph (#7)
    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
2026-10-19 Fold the rocker & dogbone designer into the Chassis Bench as a second view (#9)
    Both views live in index.html: a Whole bike / Rocker & dogbone switch under the
    header. Every designer feature carries over (both tabs, padlocks, spring and sag,
    options, fine tune, STL and SVG). New: 'Put it on the bike and show me' sends the
    design to a bench tab, respecting its padlocks; Back up/Restore and the per-tab
    reset cover the designer too. rocker.html now forwards to ./#rocker.
    Claude-Session: https://claude.ai/code/session_01FLNMn7P9NMCkJHBGgQanqd
2026-10-19 Fix sending a linkage to the tab you're on; shark's tooth rocker; drop Under the arm tab and guesses banner (#10)
    The designer's send read the bench form again after putting the design on the
    tab, so sending to the tab already showing put the old numbers straight back.
    The rocker now draws, sketches and prints as a shark's tooth hooking forwards
    (hollow front edge, rounded back), and the bench draws it the same way.
    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
2026-10-20 Rocker designer: set either rocker arm length, guard the shock side and dead spots against over-centre (#13)
    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
2026-10-20 Rocker designer: Perfect rocker tab, same numbers as Through the arm with the limits off (#17)
    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
2026-10-20 Rocker designer: drop Perfect rocker tab, suggest what to change, pin the drawing on phones (#19)
    - Remove the Perfect rocker tab and its shark's tooth check
    - When a design misses the travel or rising rate, it now tries changes on its own (singly, then the best two together), skips padlocked numbers, and each one has a Try it button
    - On phones the linkage drawing stays pinned at the top while scrolling, following the bench's pin setting
    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
2026-10-20 Rocker designer: let the rising rate be measured from a set wheel travel (#21)
    New 'Measure the rising rate from' box under What you want (default 0). The designer, the stats and the warnings measure the rising rate from that point to the bottom, and the leverage chart shades the skipped part. Over-centre and dead-spot checks still cover the whole travel.
    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
2026-10-25 Rocker designer: Rocker on the frame tab, and the whole bike can show a rocker on the frame (#22)
    Joel's new layout: the rocker pivots on the XL's lower mount, the shock's bottom
    eye bolts to it, and the dogbone runs to the CRF arm's lug. The tab starts from
    his measurements of 25 Oct with a 370 mm shock, keeps the rocker out of the
    swingarm in front of the lug, and sends the design to the whole bike, which now
    has a Rocker pivots on: Swingarm / Frame choice.
    Claude-Session: https://claude.ai/code/session_01VZ1AhVj4eHuGLTjdFCeyGN
2026-10-25 Rocker designer: lower the shock's bottom mount with an extension through the arm (up to 50 mm) (#23)
    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
2026-10-25 Rocker designer: let the shock's bottom bolt sit below the arm centreline on the Through the arm tab (#24)
    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
2026-10-25 Rocker designer: shock bolt centreline limit on the Rocker on the frame tab too (#25)
    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
2026-10-29 Add rear linkage comparison: rocker A and B built into the frame scan with the CRF250 arm
    Claude-Session: https://claude.ai/code/session_01EhMcsHQskwuSmvzBd1DjsQ
    [linkage-A-parts-only.stl, linkage-A-sag-in-frame.stl, linkage-B-parts-only.stl, linkage-B-sag-in-frame.stl]
2026-10-29 Re-place linkage assemblies in the frame scan using Joel's marked pivot and shock top
    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
    [linkage-A-parts-only.stl, linkage-A-sag-in-frame.stl, linkage-B-parts-only.stl, linkage-B-sag-in-frame.stl]
2026-10-29 Re-place linkage assemblies on Joel's corrected pivot and shock top marks
    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
    [linkage-A-sag-in-frame.stl, linkage-B-sag-in-frame.stl]
2026-10-29 Bench: add an XR250R rocker-on-frame tab with the real CRF250 arm and a rear view
    - New tab for the '86 XR250R shock (380 mm, 95 mm stroke) on the rocker-on-frame layout,
    with buttons for rockers A, B and B+ (B by default: 270 mm, 19% rising rate)
    - Side view draws the CRF250 arm outline and cross-member from Joel's model on this tab
    - New rear view card showing the side-to-side offsets: shock and rocker on the 10 mm left
    line, lug clevis about 4.5 mm right, the dogbone's 14.5 mm step, pivot width, leg gap
    - Brings in the T7 tab and the forward-of-the-lower-mount rule, which the Claude copy
    already had
    Claude-Session: https://cla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
2026-11-03 Bench XR tab: rockers C and C+ for the shock eye level with the pivot, 185 mm back
    Joel fitted the real XR250R shock: its bottom eye has to sit level with the
    swingarm pivot and 180-185 mm behind it, with the arm at 24 deg full droop.
    Rocker C (95/166, 72 deg, 97 dogbone: 238 mm, 20%) is the new default and
    C+ (74/166, 78 deg, 116 dogbone: 225 mm, 25%) sits beside it. Also carries
    the 82 mm dogbone version of rocker B from the Claude copy.
    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
2026-11-03 Rocker D/D2 drawings: pivot hole 10.8 for the M10 XL lower mount
    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
2026-11-03 Rocker D print drawing with arm/clevis notches, 1:1 DXF and SVG
    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
    [rocker-d.dxf]
2026-11-04 Rocker E: eye 209 back / 19 up, 5 mm clevis clearance, ~23 mm neck; print drawing, 1:1 DXF and SVG
    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
    [rocker-e.dxf]
2026-11-04 Rocker F: more travel (228 mm, 12%), same eye spot and clearances as E
    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
    [rocker-f.dxf]
2026-11-04 Rocker E/F drawings: move clevis label off the 192.9 dimension
    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
    [rocker-e.dxf, rocker-f.dxf]
2026-11-04 Rocker G: 80 mm bottom arm at 90 deg, 134 mm dogbone, for measured lug (150 behind / 47 below XL lower bolt)
    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
    [rocker-g.dxf]
2026-11-04 CRF-style layout check diagram (shock clashes with XL lower mount)
    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
2026-11-04 Rocker H: G with 94 mm bottom arm (best stock-mount layout from full search)
    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
    [rocker-h.dxf]
2026-11-05 Rocker J: CRF-style rocker on the arm lug with curved arm to the shock (test print)
    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
    [rocker-j.dxf]
2026-11-05 Shorter top arm options diagram
    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
2026-11-05 Rocker K: shock eye in the hole in front of the brace
    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
    [rocker-k.dxf]
2026-11-06 Rocker H printable mock-up set (STLs)
    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
    [dogbone-130-12mm.stl, dogbone-134-12mm.stl, dogbone-138-12mm.stl, rocker-h-16mm.stl, spacer-lug-left-18.5mm.stl, spacer-lug-right-10.5mm.stl, spacer-pivot-12mm-x2.stl]
2026-11-06 Rocker H 30 mm: 3D close-up animations and clash check
    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
2026-11-06 Rocker H 30 mm slotted print file
    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
    [rocker-h-30mm-slotted.stl, spacer-pivot-5mm-x2.stl]
2026-11-06 10 mm dogbones for the slotted rocker
    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
    [dogbone-130-10mm.stl, dogbone-134-10mm.stl, dogbone-138-10mm.stl]
2026-11-06 Rocker H re-solved on the CAD arm lug: 132 mm dogbone, new renders
    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
    [dogbone-132-10mm.stl, dogbone-132-12mm.stl, spacer-lug-left-5.5mm.stl, spacer-lug-right-25.5mm.stl]
2026-11-06 Rocker H renders: frame scan lined up to Joel's pivot and shock-top marks
    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
2026-11-06 Rocker H smooth curved outline, drawing, DXF, renders
    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
    [rocker-h-smooth-30mm-slotted.stl, rocker-h-smooth.dxf]
2026-11-06 Rocker H stress check and strong boxed version
    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
    [rocker-h-strong-30mm-slotted.stl, rocker-h-strong-plate.dxf]
2026-11-06 Rocker H machined 7075 version: STEP, STL, stress map
    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
    [rocker-h-alloy.step, rocker-h-alloy.stl]
2026-11-06 Add rocker M print set (22 deg droop, new lower mount)
    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
    [dogbone-46-10mm.stl, dogbone-50-10mm.stl, dogbone-54-10mm.stl, rocker-m-30mm-slotted.stl, rocker-m.dxf, spacer-lug-left-5.5mm.stl, spacer-lug-right-25.5mm.stl, spacer-pivot-5mm-x2.stl]
2026-11-11 Add optimised window layout for Joel's rocker
    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
    [rocker-joel-optimised-windows.dxf]
2026-11-11 Update optimised windows and add stress comparison
    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
    [rocker-joel-optimised-windows.dxf]
2026-11-11 Add 3D stress check of rocker with optimised windows
    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
    [rocker-joel-optimised.step]
2026-11-11 Clean 30 mm windowed rocker: STEP, renders and travel animation
    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
    [rocker-joel-optimised-clean.step]
2026-11-11 Rocker v2: 40 mm pivot, needle roller seats, eccentric dogbone bore, stress plot and renders
    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
    [rocker-joel-v2.step]
2026-11-11 Rocker v3: igus Q2 bush bores, 38 mm pivot boss, 40 mm dogbone boss, stress plot and bush stack drawing
    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
    [rocker-joel-v3-igus.step]
2026-11-11 Rocker v3: flange pockets for igus bushes, pivot boss 39.6, shock end spot faces
    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
    [rocker-joel-v3-igus.step]
2026-11-11 Rocker v3: 0.2 float each side at pivot and shock end (30 mm clevis), bush pocket section and renders
    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
    [rocker-joel-v3-igus.step]
2026-11-11 Rocker v3 window cutouts DXF
    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
    [rocker-joel-v3-windows.dxf]
2026-11-11 Rocker v3 clean window DXF (lines + arcs)
    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
    [rocker-joel-v3-windows-clean.dxf]
2026-11-11 Add sketch sheets with frame and wheel guides
    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
2026-11-11 Add sketch sheets with rough frame concept lines
    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
2026-11-11 Stress test Joel's v4 rocker (15 mm dogbone slot, M10 rose joint)
    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
    [rocker-joel-v4-15slot.step]
